ilaro-org/Calypso/README.md

# Calypso
an ffm delta 3d printer forked from the [kossel](https://github.com/jcrocholl/kossel)

check manuals for BOM and instructions on how to calibrate a delta using marlin/repetier firmwares

all sources released under GPL v3
