ilaro-org/Calypso/sources/dxf/alu bed^bed_V2.DXF

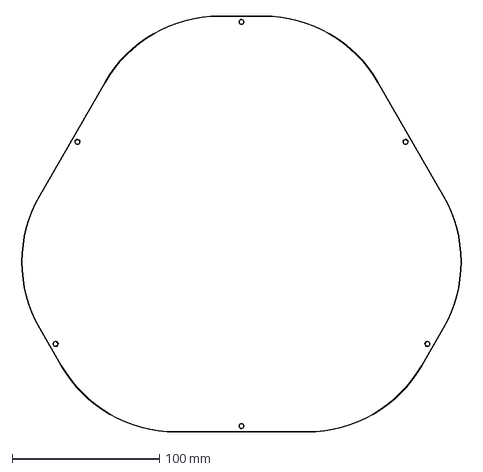
[picture p1: CAD file, 2015-12-09]
sources/dxf/alu bed^bed_V2.DXF
306.7 x 282.8 mm
