ilaro-org/Calypso/sources/stl/endstop holder_V2.STL

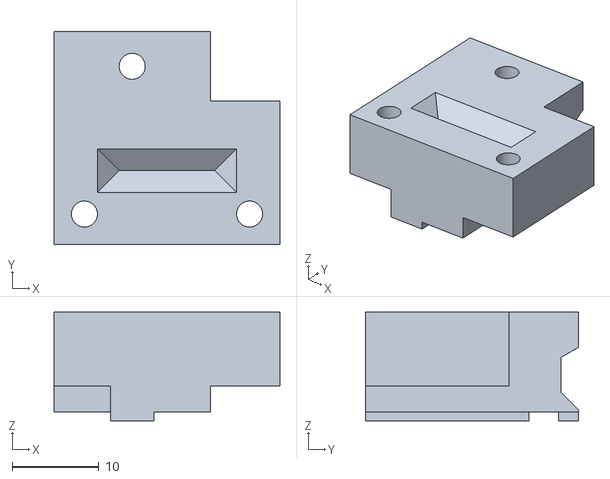
[picture p2: CAD file, 2015-12-09]
sources/stl/endstop holder_V2.STL
26.0 x 24.5 x 12.5
