ilaro-org/Calypso/sources/dxf/subbed_V2.DXF

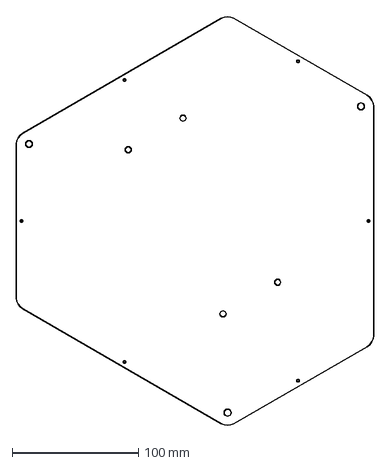
[picture p3: CAD file, 2015-12-09]
sources/dxf/subbed_V2.DXF
282.8 x 324.3 mm
