ilaro-org/Calypso/sources/stl/vertex_V2.STL

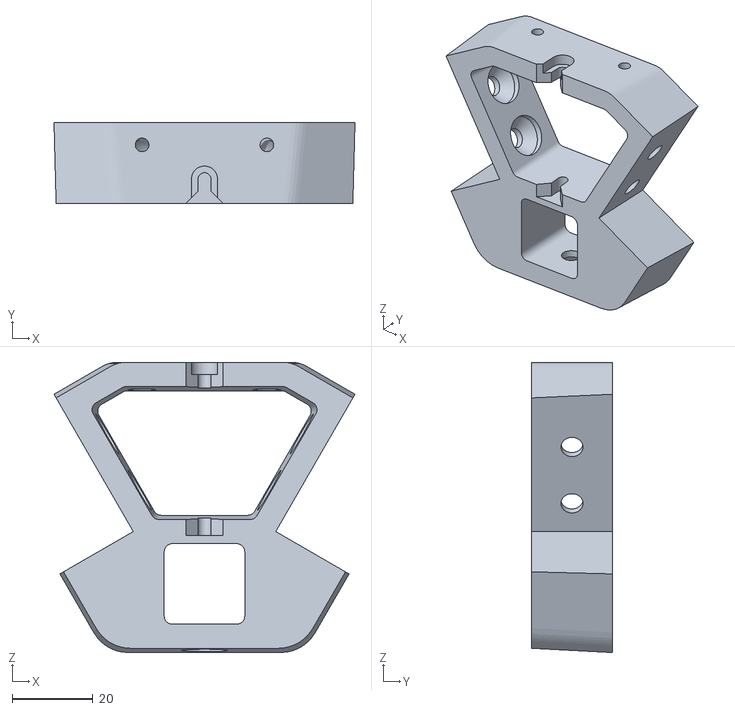
[picture p4: CAD file, 2015-12-09]
sources/stl/vertex_V2.STL
74.8 x 20.0 x 72.0
