ilaro-org/Calypso/sources/dxf/front plate holder_2.DXF

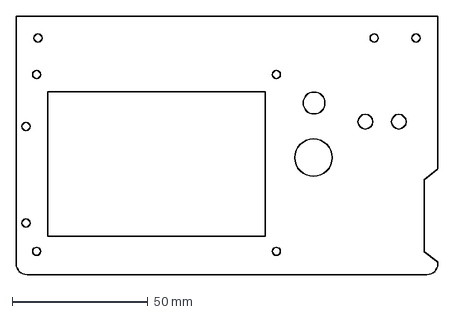
[picture p5: CAD file, 2015-12-09]
sources/dxf/front plate holder_2.DXF
155.0 x 95.0 mm
