ilaro-org/Calypso/sources/stl/hotend holderb_v4.STL

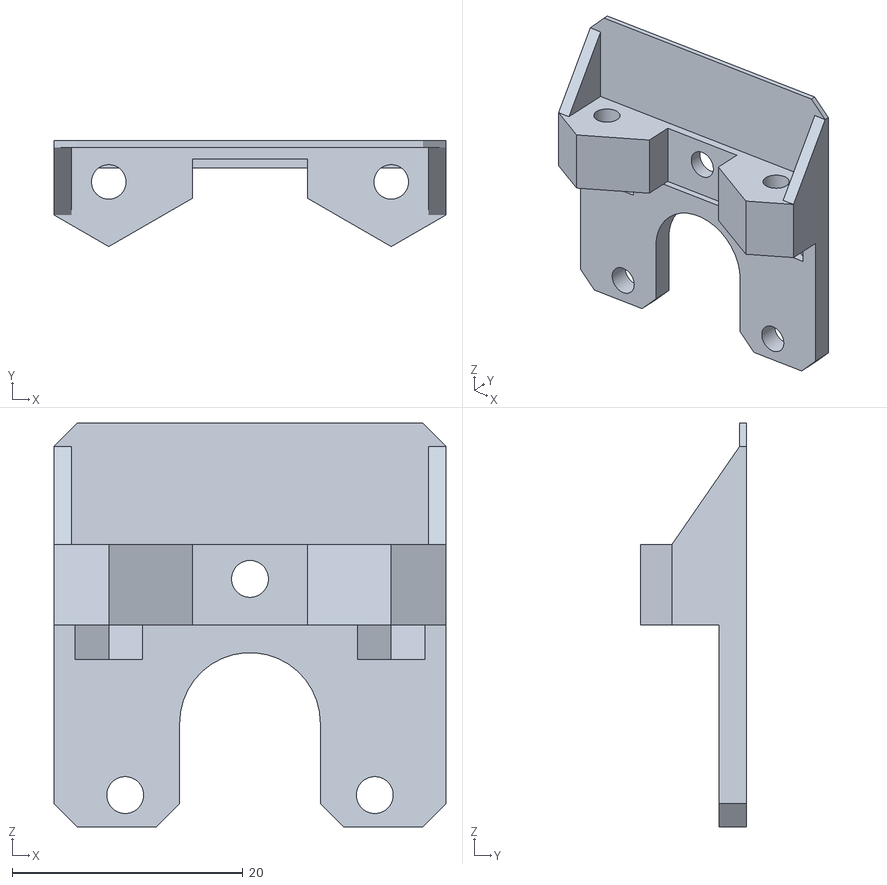
[picture p6: CAD file, 2015-12-09]
sources/stl/hotend holderb_v4.STL
34.0 x 9.21 x 35.0
