ilaro-org/Calypso/sources/dxf/power_plate_V2.DXF

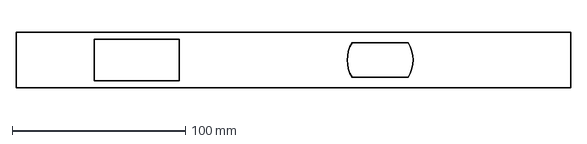
[picture p7: CAD file, 2015-12-09]
sources/dxf/power_plate_V2.DXF
320.0 x 32.2 mm
