ilaro-org/Calypso/sources/stl/extruder holder_V2.STL

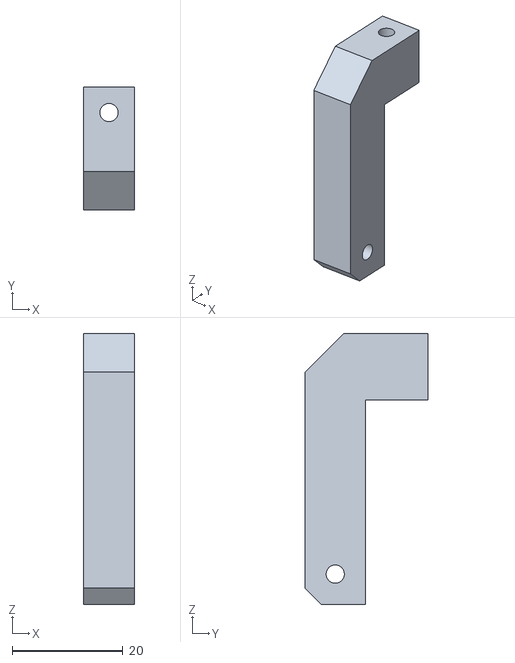
[picture p8: CAD file, 2015-12-09]
sources/stl/extruder holder_V2.STL
9.30 x 22.3 x 49.0
