ilaro-org/Calypso/sources/stl/Push filament_V2.STL

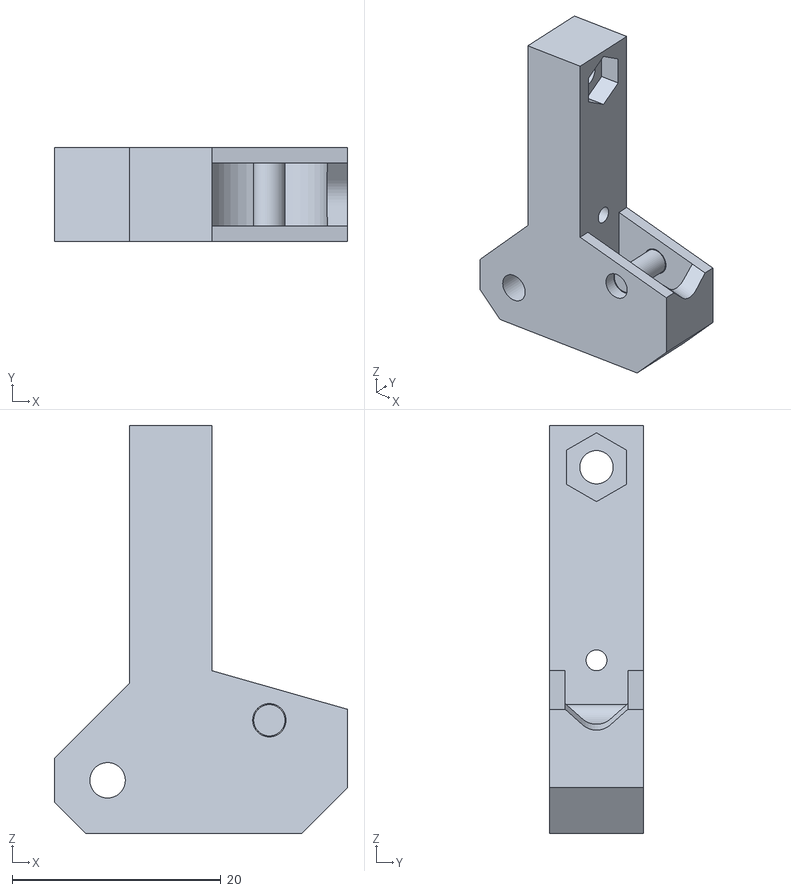
[picture p9: CAD file, 2015-12-09]
sources/stl/Push filament_V2.STL
28.1 x 9.00 x 39.1
