ilaro-org/Calypso/sources/stl/layerfan duct.STL

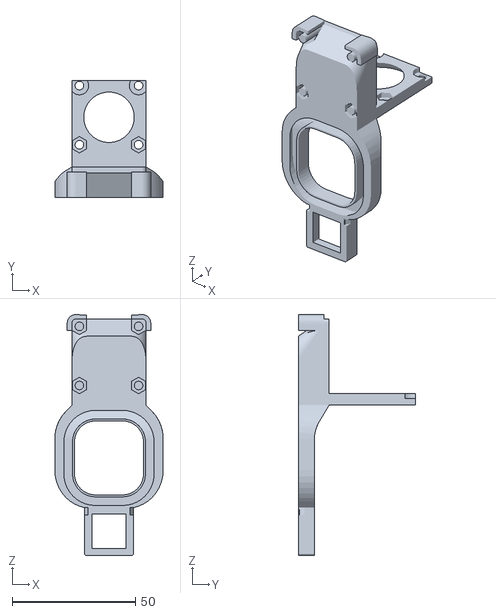
[picture p10: CAD file, 2015-12-09]
sources/stl/layerfan duct.STL
44.0 x 47.6 x 97.8
