ilaro-org/Calypso/sources/stl/Pull filament_V2.STL

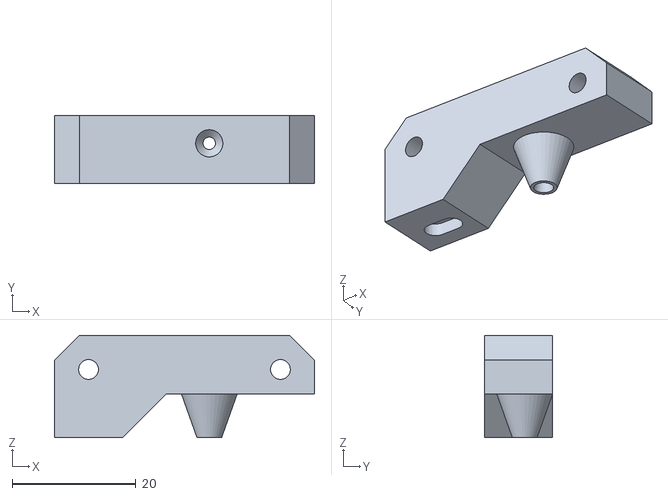
[picture p11: CAD file, 2015-12-09]
sources/stl/Pull filament_V2.STL
42.0 x 11.0 x 16.5
