ilaro-org/Calypso/sources/stl/carriage_V2.STL

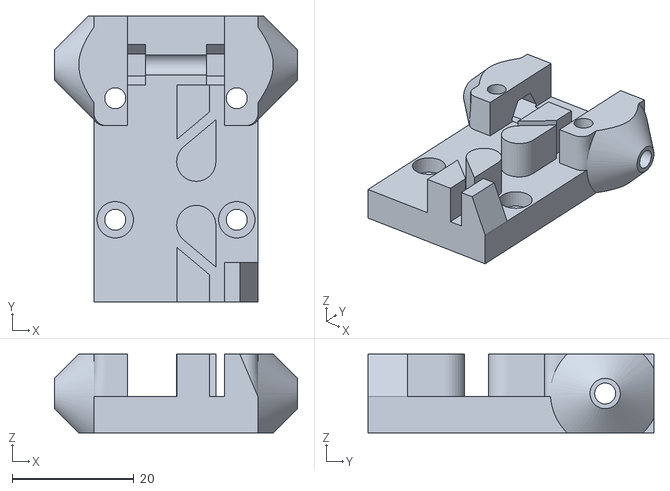
[picture p12: CAD file, 2015-12-09]
sources/stl/carriage_V2.STL
40.0 x 47.0 x 13.0
