ilaro-org/Calypso/sources/stl/spool_V2.STL

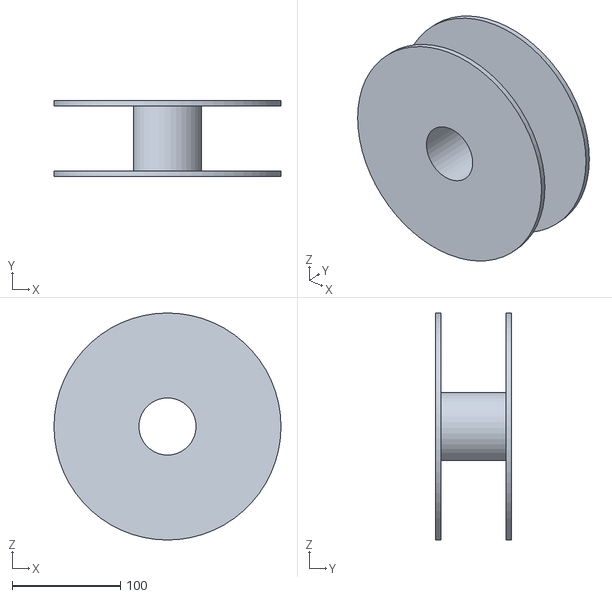
[picture p13: CAD file, 2015-12-09]
sources/stl/spool_V2.STL
210.0 x 70.0 x 210.0
