ilaro-org/Calypso/sources/stl/endeffector_V2.STL

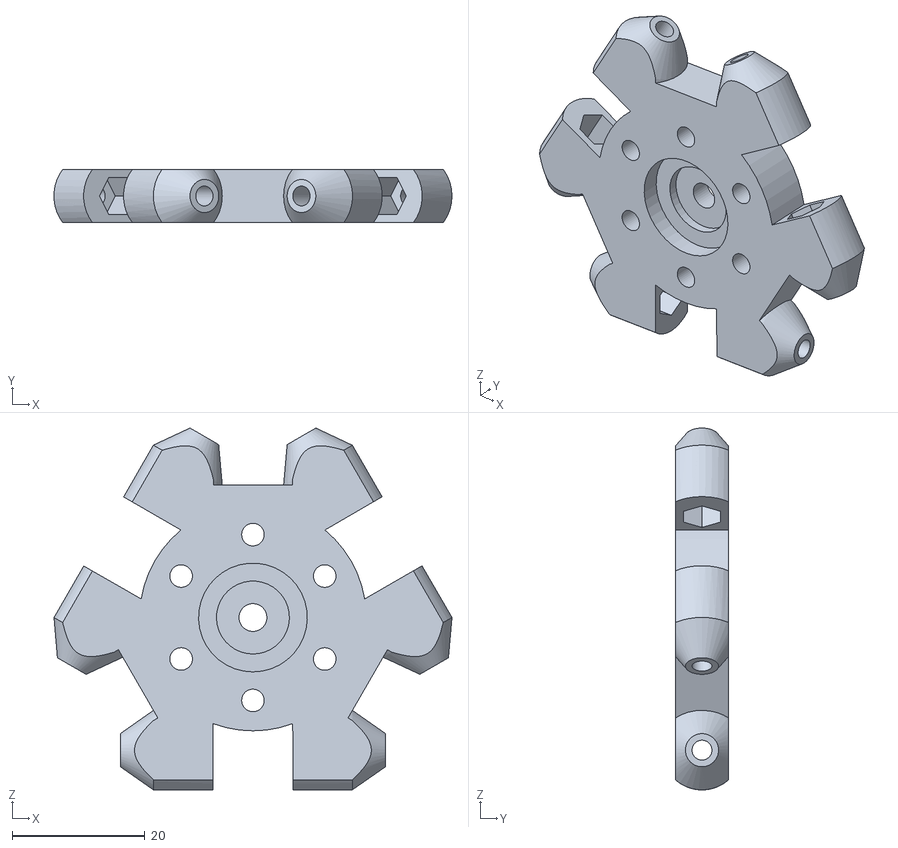
[picture p14: CAD file, 2015-12-09]
sources/stl/endeffector_V2.STL
60.0 x 8.00 x 54.6
