ilaro-org/Calypso/manuals/manual_Clayprinter_ingles.pdf

# CLAY

### VERSION 1

## ILARO.ORG

### 3D PRINTING MANUAL WITH EXTRUSION OF PASTES

CALYPSO DELTA - LICENCIA GPL.V3.

# Modified Printer for extrusion of pastes

# 1.Auger

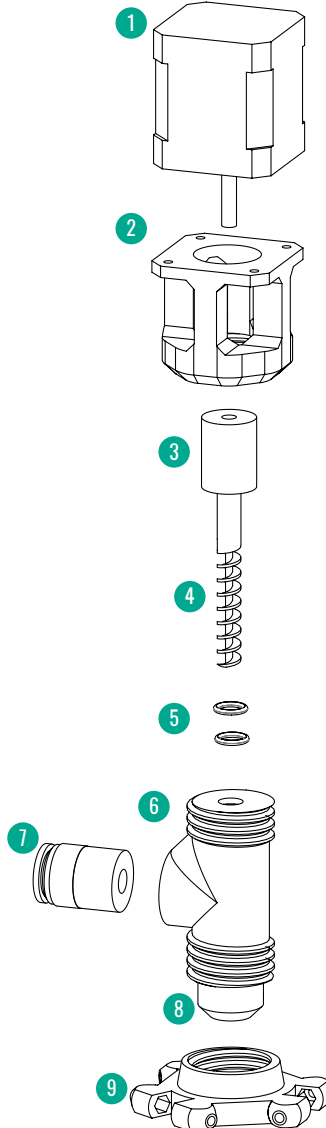
[picture p24: figure]

1 - Motor Nema 17
2 - Motor Coupler
3 - Coupling
4 - Auger Screw
5 - o - Ring
6 - Stator
7 - Racor G1-2
8 - Nozzle
9 - End effector

CALYPSO DELTA printer modified for 3d printing of paste extrusion. The extruder has been modified and has an inlet that is connected to a clay container. This clay is extruded thanks to the force of an air compressor at 4 -6 bar.
A motor connected with a coupler to a worm screw has been incorporated that allows to control the passage of the clay and to make retractions.
The noozle is 2.5 mm and 5 mm in diameter. The maximum printing volume is 280 diameter x 340 mm.

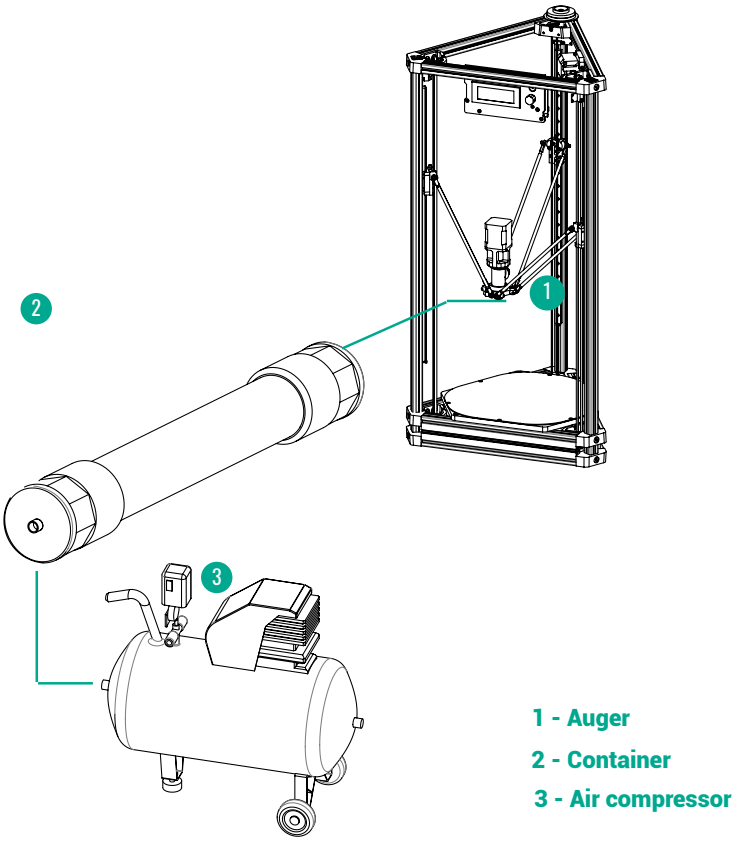
[picture p25: figure]
1 - Auger 2 - Container 3 - Air compressor

# 2.clay container

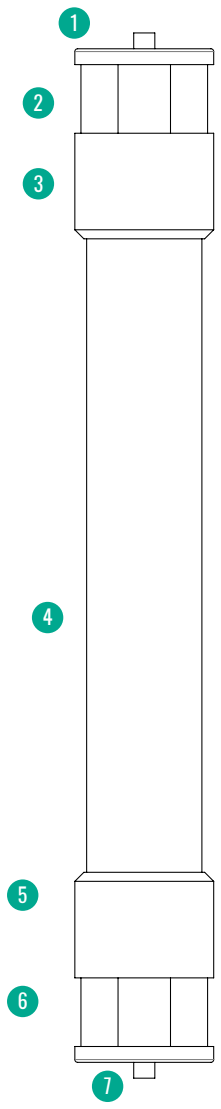
[picture p26: figure]

1 - Racor G1-2

7 - Racor G1-2

2 - Plug 2” inches

6 - Plug 2” inches

3 - Thread 2 “inches

5 - Thread 2 “inches

4 - PVC tube pressure 63 mm diameter

STEP 1 STEP 2
Export the file from Grasshopper | Export as .gcode

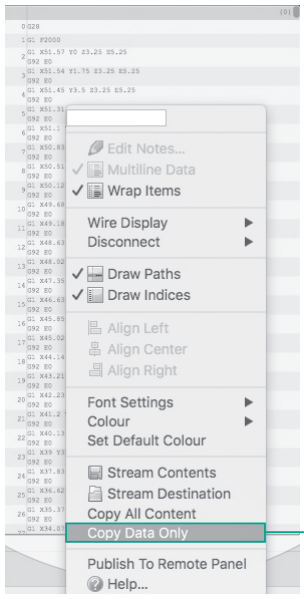
[picture p27: figure]
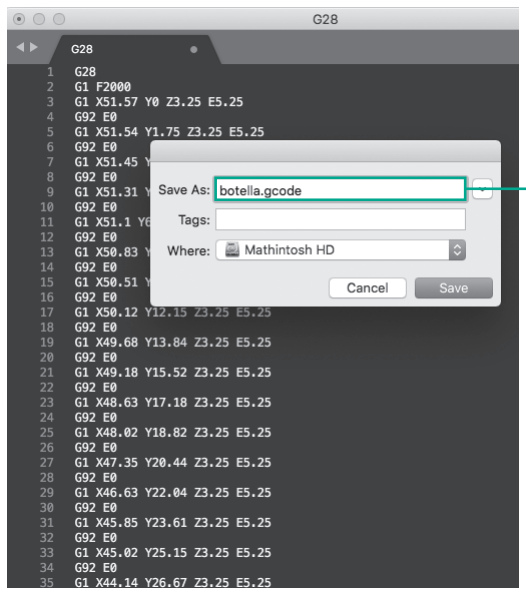
[picture p28: figure]

To print in 3d we need to export the code that we will find in the Grasshopper file.
Select the last panel and right click.
Select “Copy Data Only”.

Next we will open a text or source code editor such as “Sublime text”.
or by default the one that we will have in the computer as “notes”.

Copy the code and save it on an SD card as: name.gcode

STEP 3 STEP 4
preparation | container

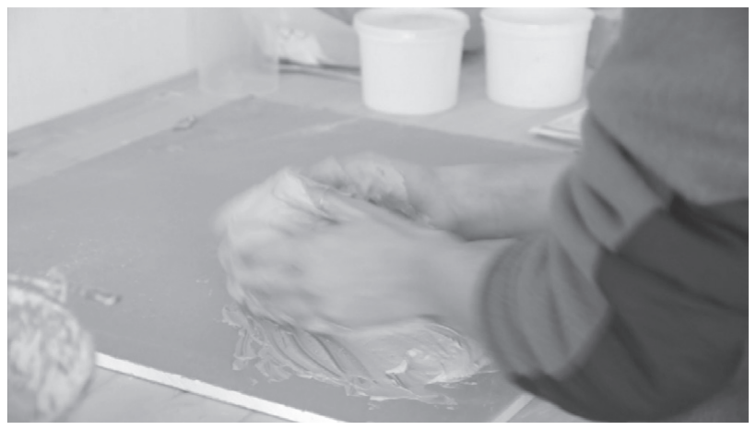
[picture p29: figure]

For the load of paste we will be able to use:

- High temperature stoneware without deflocculant
- High-temperature B2 porcelain without deflocculant.

It is important that the paste is not deflocculated since normally the ceramic powders come prepared to make molds, the deflocculant allows that with less amount of water the clay has fluidity and plasticity. For 3d printing we are interested in the clay maintaining its original structure and not being processed.

We will calculate a proportion that has the consistency that we look for to extrude with the printer.

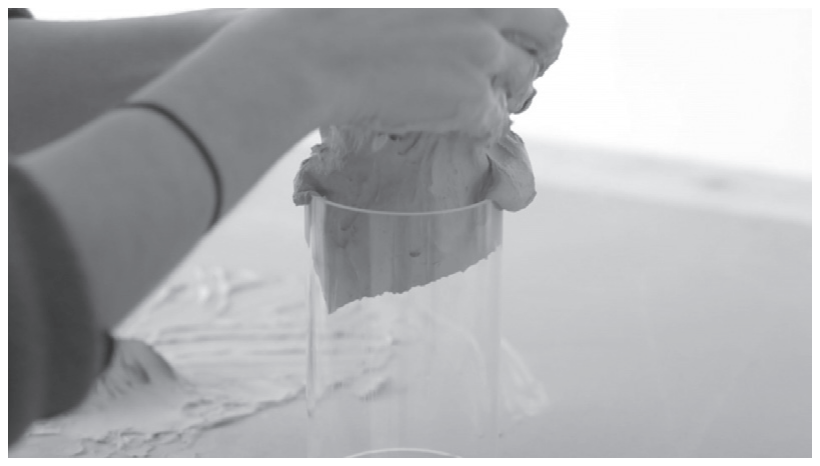
[picture p30: figure]

### 1 part water x 3 part clay

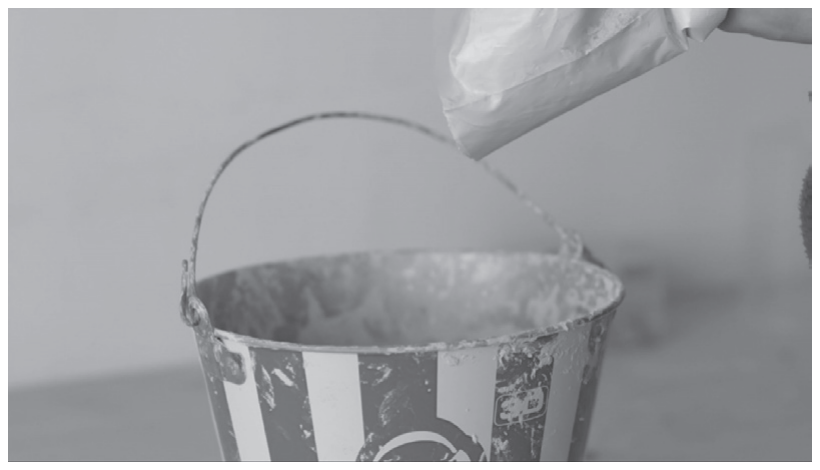
[picture p31: figure]

for this container we need 1900 grams of Stoneware.

Knead with your hands on a flat surface until a homogeneous dough is obtained.

without letting air bubbles into the container.

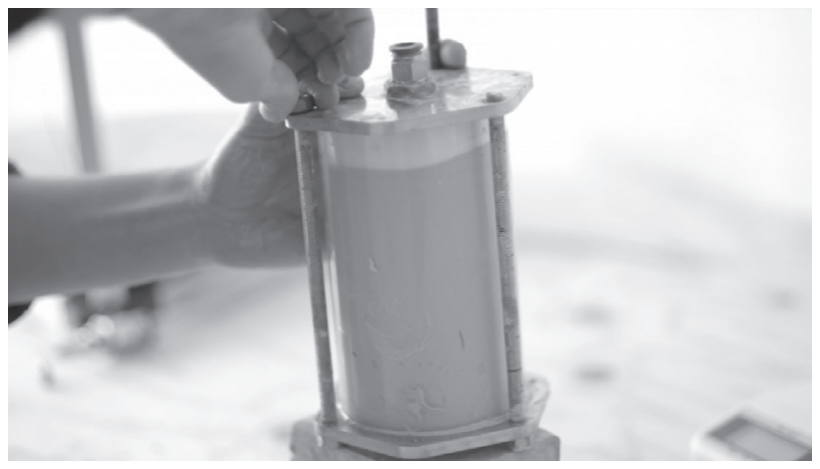
[picture p32: figure]

close the container making sure that it is tight and there are no air leaks.

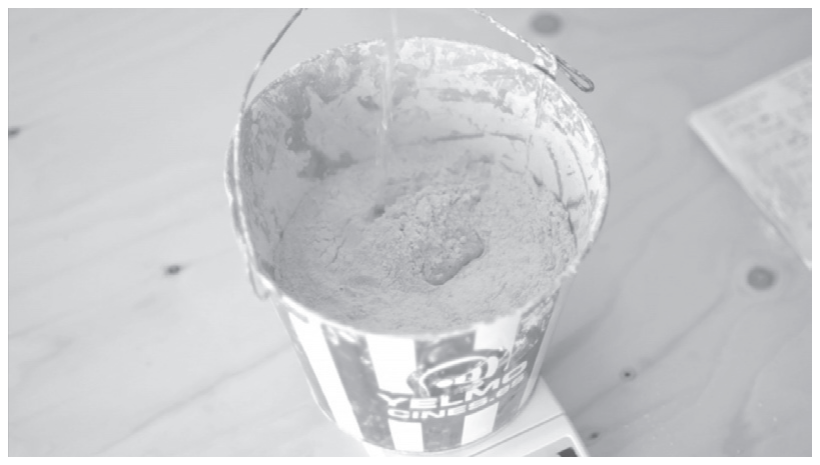
[picture p33: figure]

we need 633,33 ml of water

STEP 5 STEP 6
Connect to air compressor | Printing the file

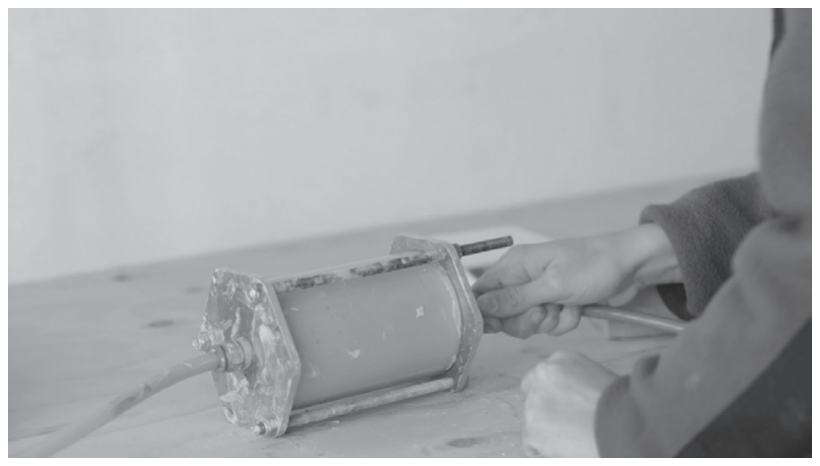
[picture p34: figure]

Connect the container to the air compressor by adjusting the tube well, making sure that no air is lost.

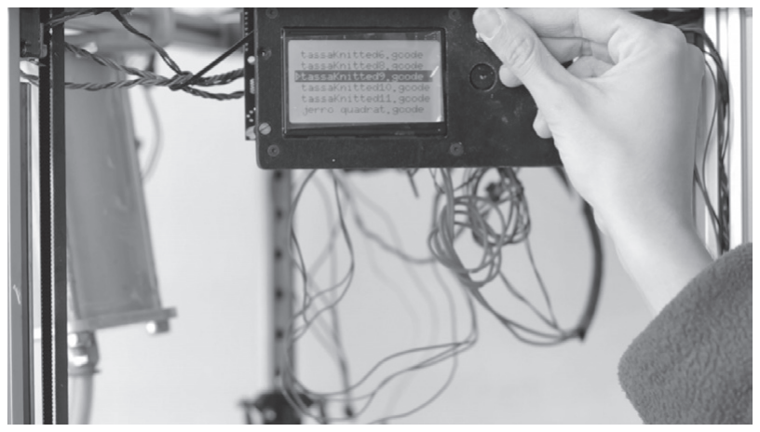
[picture p35: figure]

Connect SD to the printer slot on the left side of the screen. Automatically the menu of the sd card will appear and with the metallic button we will look for our file.
Otherwise we will search in the printer menu “Print file”.

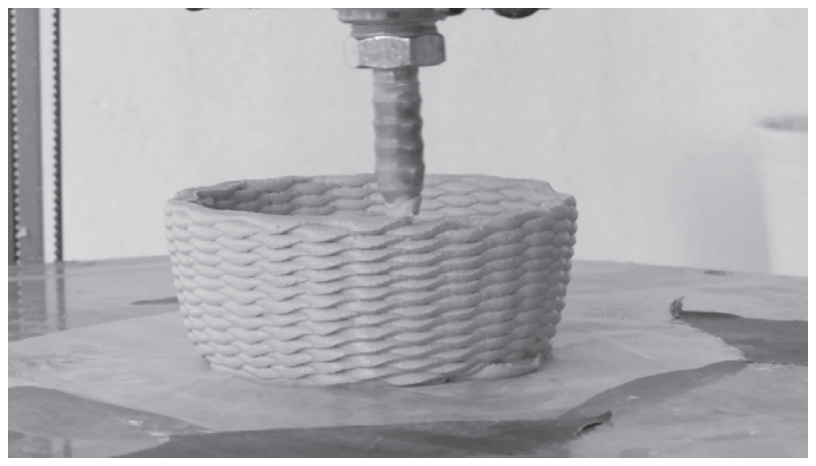
[picture p36: figure]
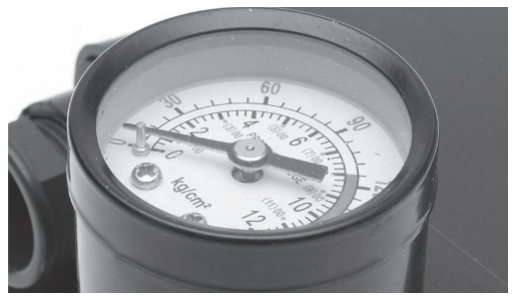
[picture p37: figure]

Adjust the air force of the compressor.
Normally we use a paste of this density between 4 to 6 bars. We must fix this force well so that a homogeneous piece comes out.

Our file will then be printed.
We must continuously ensure that the force of the air is constant and that the container does not lose air.

If the part does not extrude well it is possible that :
- clay has dried in the nozzle.
- Do not have enough force to extrude the paste and we must raise the bars of the compressor.
- The code is not correct.
- Lose air

2019 | ilaro.org

LICENCIA GPL.V3.

MANUAL by
Valeria Ustárez
