ilaro-org/Calypso/manuals/manual_Cnc_ingles.pdf

# CNC

### VERSION 1

## ILARO.ORG

### MANUFACTURING MANUAL SUSTRACTIVE

CALYPSO DELTA - LICENCIA GPL.V3.

Subtractive (CNC, turning, drilling) | Agama cnc

1 -Frame Y
2 - Frame X

Subtractive manufacturing begins with a block of solid material, and uses cutting tools
to extract the material and achieve a final shape. Milling, turning, drilling and cutting operations are examples of subtractive techniques. Subtractive manufacturing is capable of producing high precision parts with excellent surface finish.

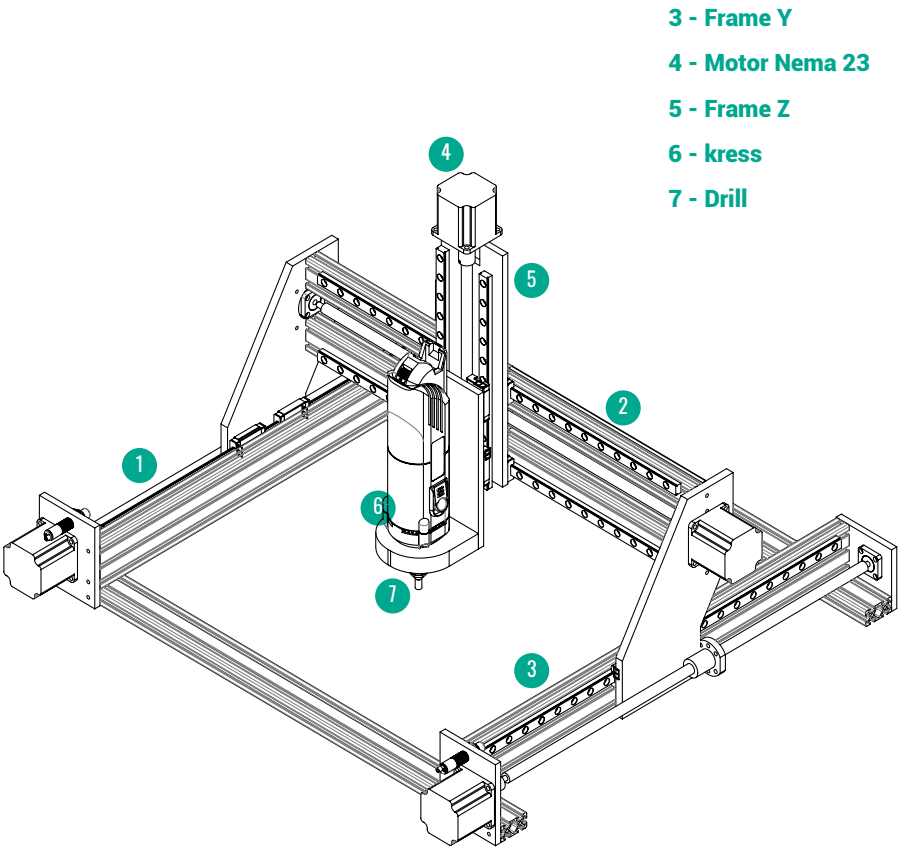
[picture p38: figure]
3 - Frame Y 4 - Motor Nema 23 5 - Frame Z 6 - kress 7 - Drill

Subtractive manufacturing is limited by a number of factors. Most designs require computer-aided manufacturing (CAM) to trace tool paths and efficient material removal. Tool access must also be taken into account when designing parts for subtractive manufacturing, as the cutting tool must be able to reach all surfaces to remove material.

Subtractive manufacturing is also generally considered a wasteful process, due to the large amounts of material that are often removed to produce the final part geometry.

STEP 1 STEP 2
Export the file from Grasshopper | Export as .ngc

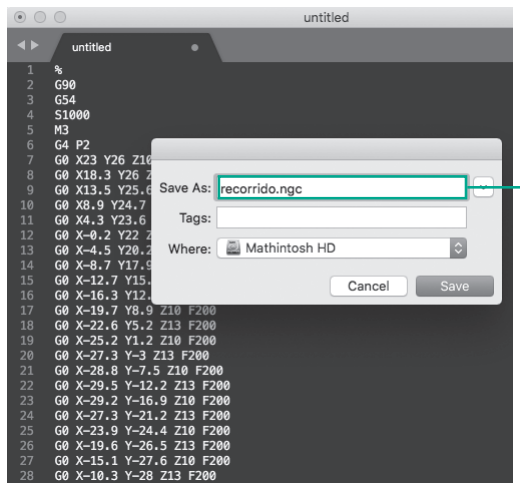
[picture p39: figure]
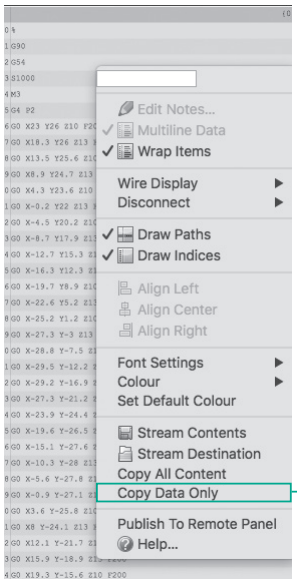
[picture p40: figure]

we need to export the code we’ll find in the Grasshopper file.
Select the last panel and right click.
And then select “Copy Data Only”.

We open a text or source code editor such as “Sublime text”. or by default the one that we will have in the computer as “notes”.

We will copy the code and save it in a Pen drive as: name.ngc

STEP 3 STEP 4
Save in TEC2 folder on the desktop | open Machinekit

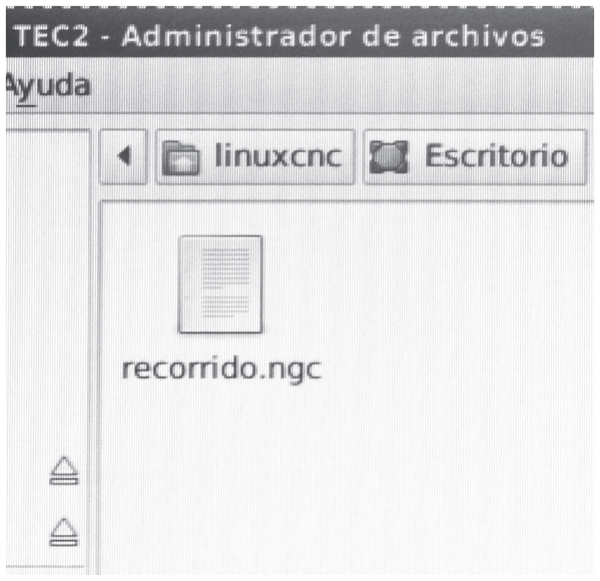
[picture p41: figure]

We’ll save our file in the desktop folder called TEC2.

We open in the Machinekit desktop.( with the name of the cnc that we are using) It is a platform for machine control applications.

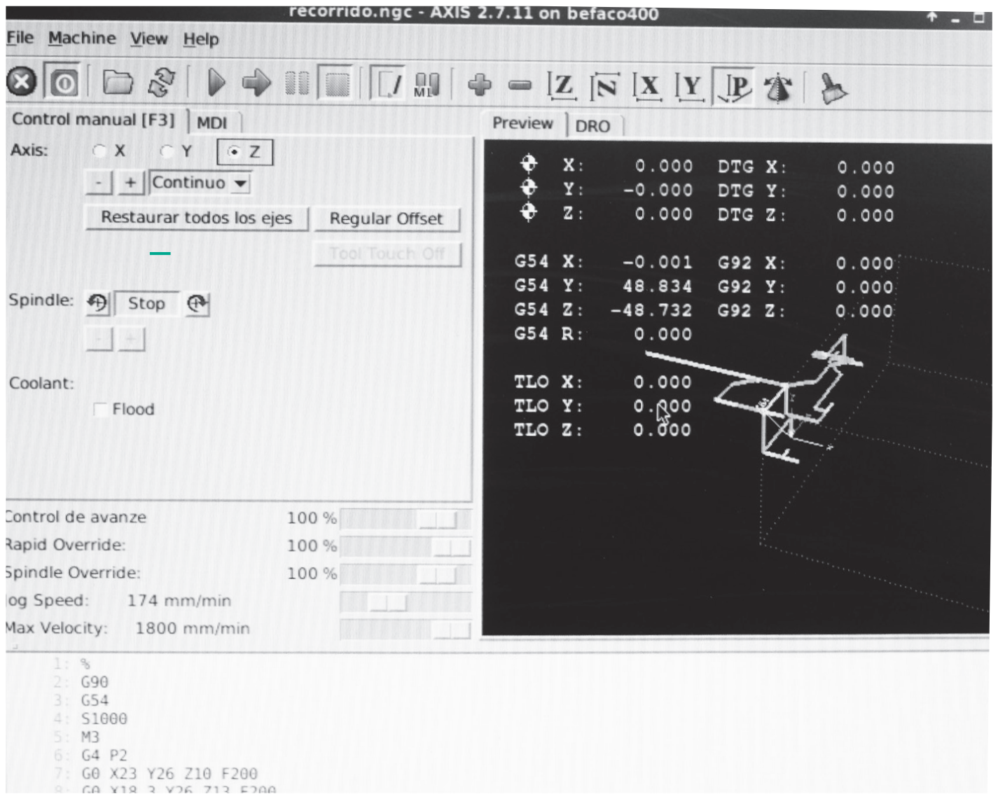
[picture p42: figure]

STEP 5

# Fix material

STEP 6

# Change drill bit

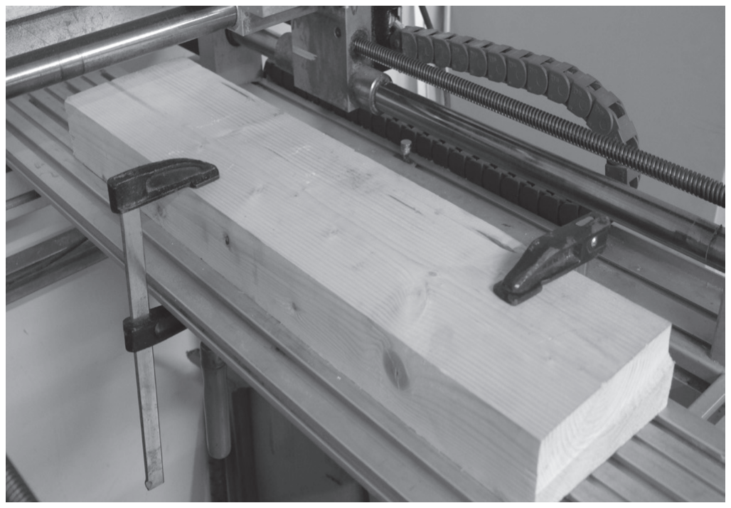
[picture p43: figure]
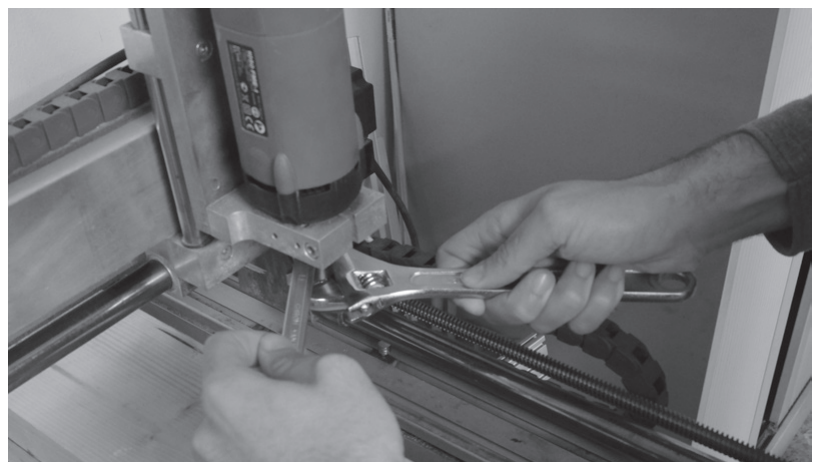
[picture p44: figure]

We can change the drill bit with two wrenches pressing in.

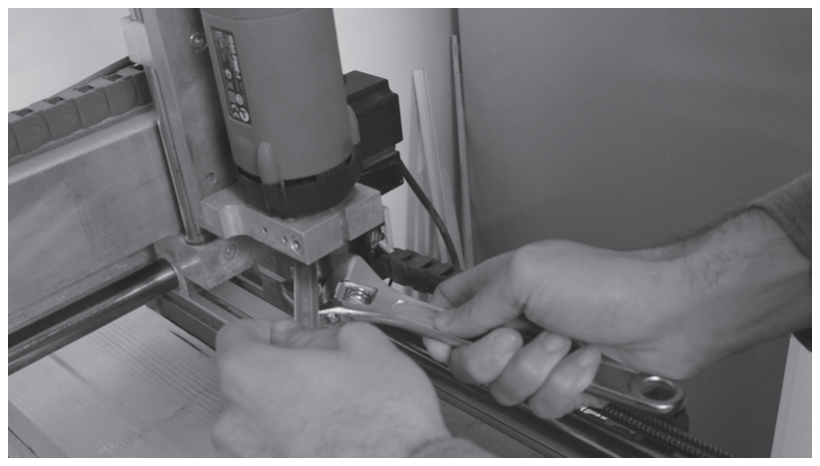
[picture p45: figure]

To adjust drill press out.

STEP 7 STEP 8
Open .ngc file from Machinekit | Turn on/restore all axes

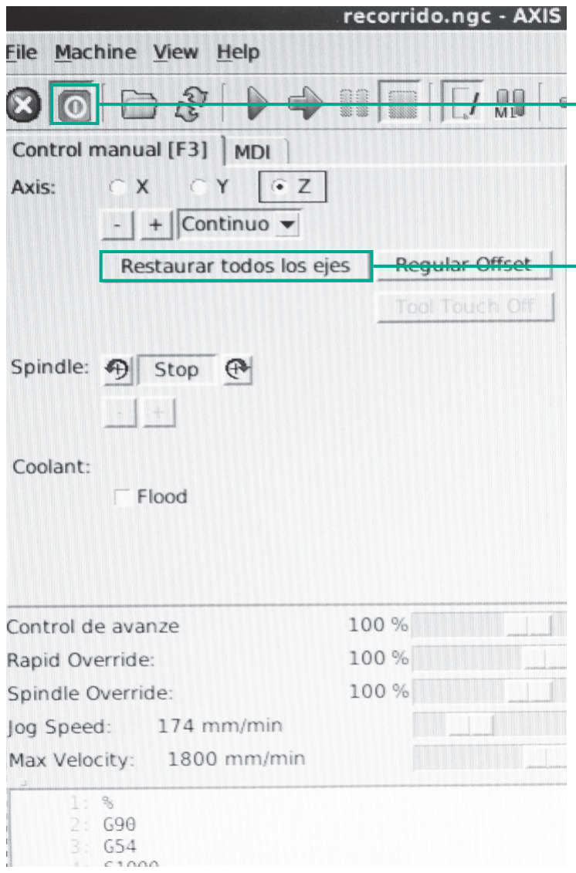
[picture p46: figure]
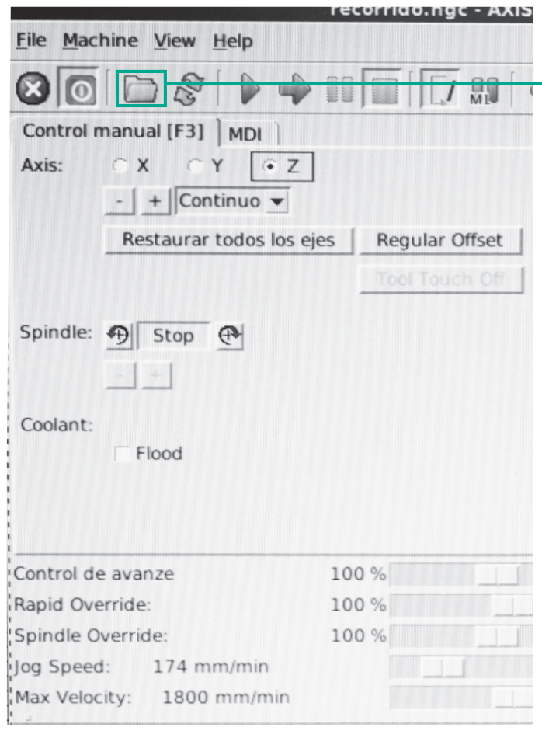
[picture p47: figure]

Turn on the cnc from Machinekit and restore all the axes (home)

We look for the icon of the folder to open the file in TEC2

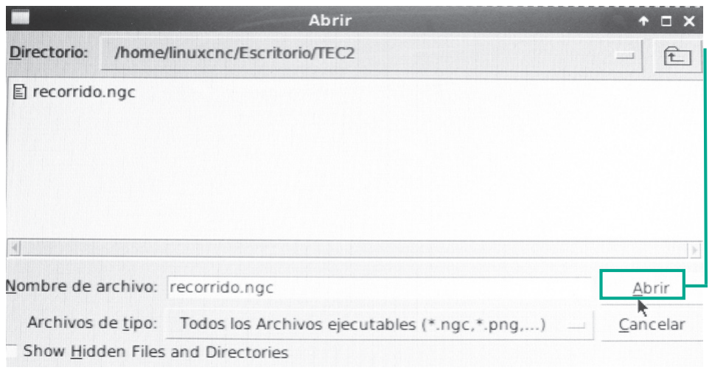
[picture p48: figure]

We look for the TEC2 folder on the desktop and proceed to open.

STEP 9 STEP 10

# Commands to move with the machine

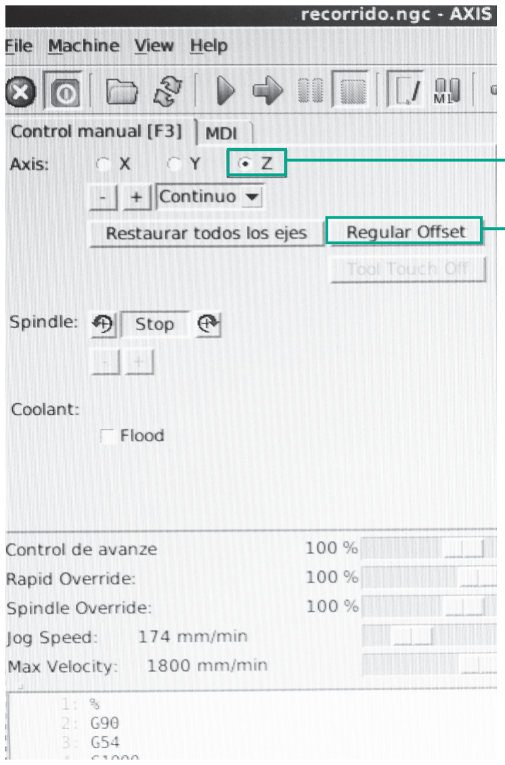
[picture p49: figure]

Move on the XY axes
right left

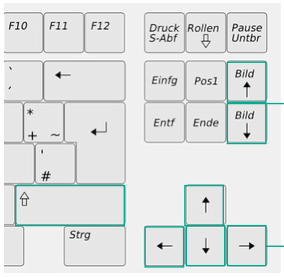
[picture p50: figure]

Move in the Z axes

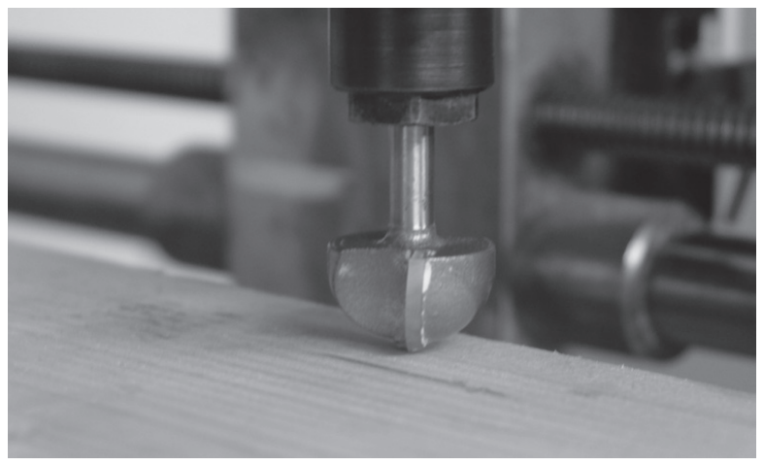
[picture p51: figure]

To move in the space we will use the following commands in the keyboard:

Pressing:

SHIFT (to go faster)+ (XYZ axis keys)

Select our start of coordinate axis by placing the drill in position “X0 Y0 Z0”.

# X Y Z axis configuration

To define our position
X0 Y0 Z0.

Let’s select for example:
the Axis Z and then select Regular offset. Repeat the operation with the axis Y , X

STEP 11 STEP 12

# start

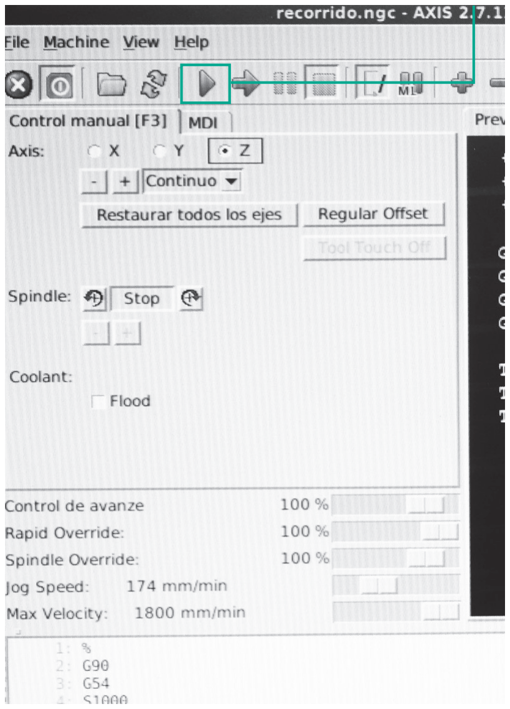
[picture p52: figure]
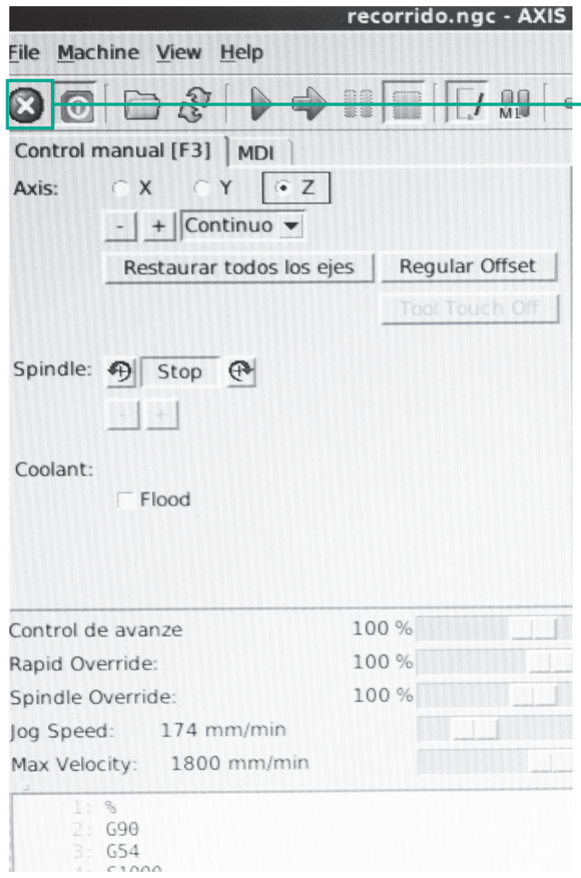
[picture p53: figure]

To cancel printing press this button

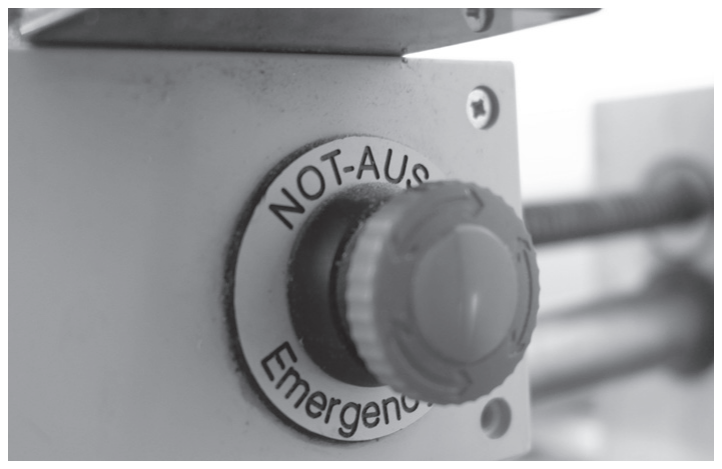
[picture p54: figure]
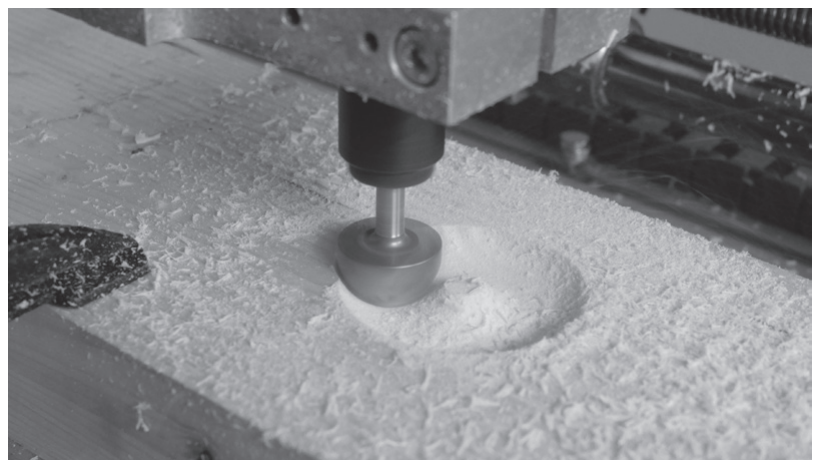
[picture p55: figure]

EMERGENCY OFF

# Emergency Power Off

play to start

2019 | ilaro.org

LICENCIA GPL.V3.

MANUAL BY
Valeria Ustárez
