ilaro-org/Calypso/manuals/manual cnc.pdf

# CNC

### VERSION 1

## ILARO.ORG

### MANUAL DE FABRICACIÓN SUSTRACTIVA

CALYPSO DELTA - LICENCIA GPL.V3.

Sustractivo (CNC, torneado, taladrado) | Agama cnc

1 -Frame Y
2 - Frame X

La fabricación sustractiva comienza con un bloque de material sólido, y utiliza
herramientas de corte para extraer el material y lograr una forma final. Las operaciones de fresado, torneado, taladrado y de corte, son ejemplos de técnicas sustractivas. La fabricación sustractiva es capaz de producir piezas de alta precisión con un excelente acabado superficial.

3 - Frame Y 4 - Motor Nema 23 5 - Frame Z 6 - kress 7 - Drill

La fabricación sustractiva está limitada por una serie de factores. La mayoría de los diseños requieren fabricación asistida por ordenador (CAM) para trazar las trayectorias de las herramientas y la eliminación eficiente del material.
El acceso a la herramienta también debe tenerse en cuenta al diseñar piezas para la fabricación sustractiva, ya que la herramienta de corte debe ser capaz de llegar a todas las superficies para eliminar material.

La fabricación sustractiva también se considera generalmente un proceso derrochador, debido a las grandes cantidades de material que a menudo se eliminan para producir la geometría final de la pieza.

STEP 1 STEP 2
Exportar el archivo desde Grasshopper | Exportar como .ngc


necesitamos exportar el código que encontraremos en el archivo de Grasshopper. Seleccionaremos el último panel y damos click derecho.
Y a continuación seleccionamos “ Copy Data Only”

Abrimos un editor de texto o de código fuente como por ejemplo “Sublime text“.
o por defecto el que tendremos en el ordenador como “notes”.

Copiaremos el código y lo
guardaremos en un Pen drive como: nombre.ngc

STEP 3 STEP 4
guardar en carpeta TEC2 en el escritorio | abrir Machinekit


Guardaremos nuestro archivo en la carpeta del escritorio llamada TEC2.

Abrimos en el escritorio Machinekit.( con el nombre de la cnc que estamos utilizando) Es una plataforma para aplicaciones de control de máquinas.


STEP 5

# Fijar material

STEP 6

# Cambiar broca


Podemos cambiar la broca con dos llaves inglesas presionando hacia dentro.


Para ajusta broca presionar hacia fuera.

STEP 7 STEP 8
Abrir archivo .ngc desde Machinekit | Encender/Restaurar todos los ejes


Encendemos la cnc desde Machinekit y restauramos todos los ejes (home)

Buscamos el icono de la carpeta para abrir el archivo de la carpeta
TEC2


Buscamos la carpeta TEC2 en el escritorio y procedemos a abrir.

STEP 9 STEP 10

# Comandos para movernos con la máquina


Movernos en los ejes XY
derecha izquierda


Movernos en los ejes Z
derecha izquierda


Para movernos en el espacio utilizaremos los siguientes comandos en el teclado:

Presionando:

SHIFT (para ir más rápido)+ (teclas ejes XYZ)

Seleccionamos nuestro inicio de eje de coordenadas colocando la broca en la posición “ X0 Y0 Z0 ”.

# Configuración de ejes X Y Z

Para definir nuestra posición
X0 Y0 Z0.

Seleccionaremos por ejemplo:
el Axis Z y luego seleccionaremos Regular offset. Repetiremos operación con el axis Y , X

STEP 11 STEP 12

# Inicio


Para cancelar la impresión apretar a este botón


Apagado de EMERGENCIA

# Apagado de emergencia

darle al Play

2019 | ilaro.org

LICENCIA GPL.V3.

MANUAL REALIZADO POR
Valeria Ustárez
