ilaro-org/Calypso/manuals/manual 3Dprinter.pdf

# PLA

### VERSION 1

## ILARO.ORG

### MANUAL DE IMPRESIÓN 3D CON FILAMENTOS

CALYPSO DELTA - LICENCIA GPL.V3.

Additive (3D printing) | Calypso Delta


1 - Pla Filament
2 - SD Card
3 - Shield LCD
4 - Pull filament
5 - Push fit
6 - Heatsink
7 - Fan
8 - Noozle
9 - Hot bed
10 - Power On/Off

La fabricación aditiva (más comúnmente conocida como impresión en 3D) es el proceso de construcción aditiva de una pieza, capa a capa. Existe una amplia gama de tecnologías de impresión en 3D, cada una con sus propios beneficios y limitaciones, y cada una es capaz de imprimir piezas de diferentes materiales.

Se puede producir casi cualquier geometría, es uno de los puntos fuertes de la impresión en 3D (aunque todavía hay reglas que debemos tener en cuenta segun la tecnología). Además, la impresión en 3D no se basa en costosas herramientas, lo que tiene como ventaja la rápida verificación y desarrollo de prototipos y piezas de producción de bajo volumen.
Una de las mayores limitaciones de la impresión en 3D es la incapacidad de producir piezas con propiedades de material equivalentes a las realizadas mediante técnicas sustractivas o formativas.

La impresión en 3D también tiene limitaciones en cuanto a la repetibilidad, lo que significa que las piezas a menudo presentan ligeras variaciones debido al enfriamiento diferencial o a la deformación durante el curado.

STEP 1 STEP 2
Exportar el archivo .STL | Configuración del laminado


Para imprimir con la impresora 3d necesitamos un modelo STL . El archivo lo podemos conseguir previamente modelando el objeto con cualquier software de modelado 3D (Sketchup, Rhinoceros, SolidWorks, etc..)


Seleccionamos “guardar como” y guardamos con la extensión .stl (Stereolithography)

Layer height (mm)
altura de capa entre 0.1 a 0.4.
a menor altura más calidad.

Shell thickness (mm)
Este parámetro determina la anchura del borde del objeto (diámetro de la boquilla del hotend x num. de vueltas que queramos dar al objeto)

Fill Density (%)
este valor indica el relleno que va a tener la figura. 20% para piezas artísticas , 80% para piezas que deban soportar peso o esfuerzos.

Enable retraction
Esta opción permite que en los desplazamientos el extrusor retraiga un poco el plástico para que no gotee

Printing temperature (C)
temperatura del hotEnd a la que vamos a imprimir. Para el PLA entre 190º-210º Support type
crea soportes donde sea necesario en partes de la pieza que estan al aire y no se pueden suspender.

Filamet diameter (mm)
Establece el diámetro del filamento que estemos usando. En nuestro caso siempre será 1.75 mm

Para imprimir nuestro archivo .STL utilizaremos CURA, que es un programa “Open Source” desarrollado por ultimaker para el laminado de objetos 3D. Desde este programa se pueden realizar todos los pasos necesarios para pasar de un modelo 3D a un objeto real. A continuación explicaremos los parámetros mas importantes a tener en cuenta para imprimir nuestra pieza.

STEP 3 STEP 4

# Imprimir


Insertar tarjeta SD en la ranura de la pantalla por la parte izquierda


Seleccionar apretando el botón metálico.

Imprimiendo


Buscar nuestro archivo .gcode en el menu de la tarjeta girando el botón metálico

Después exportaremos como
nombre.gcode y lo guardaremos en una tarjeta SD

# Exportar el archivo .gcode

2019 | ilaro.org

LICENCIA GPL.V3.

MANUAL REALIZADO POR
Valeria Ustárez
