ilaro-org/Calypso/manuals/manual Clayprinter.pdf

# CLAY

### VERSION 1

## ILARO.ORG

### MANUAL DE IMPRESIÓN 3D CON EXTRUSIÓN DE PASTAS

CALYPSO DELTA - LICENCIA GPL.V3.

# Impresora modificada para extrusión de pastas

# 1.Auger


1 - Motor Nema 17
2 - Motor Coupler
3 - Coupling
4 - Auger Screw
5 - o - Ring
6 - Stator
7 - Racor G1-2
8 - Nozzle
9 - End effector

Impresora CALYPSO DELTA modificada para la impresión 3d de extrusión de pastas. Se ha modificado el extrusor y tiene una entrada que esta conectada a un contenedor de barro. Este barro se extruye gracias a la fuerza de un compresor de aire a 4 -6 bar.
Se ha incorporado un motor conectado con un coupler a un tornillo sin fin que permite controlar el paso del barro y hacer retracciones.
El noozle es de 2,5 mm y 5 mm de diámetro . El máximo volumen de impresión es de 280 diámetro x 340 mm.

1 - Auger 2 - Container 3 - Air compressor

# 2.Contenedor de pasta


1 - Racor G1-2

7 - Racor G1-2

2 - Tapón 2“ pulgadas

6 - Tapón 2“ pulgadas

3 - Rosca 2“pulgadas

5 - Rosca 2“pulgadas

4 - Tubo PVC presión 63 mm de diámetro

STEP 1 STEP 2
Exportar el archivo desde Grasshopper | Exportar como .gcode


Para imprimir en 3d necesitamos exportar el código que encontraremos en el archivo de Grasshopper.
Seleccionaremos el último panel y damos click derecho.
Seleccionamos “ Copy Data Only”

A continuación abriremos un editor de texto o de código fuente como por ejemplo “Sublime text“. o por defecto el que tendremos en el ordenador como “notes”.

Copiaremos el código y lo
guardaremos en una tarjeta SD como: nombre.gcode

STEP 3 STEP 4
Preparación de pasta | carga de contenedor


Para la carga de pasta podremos utilizar:

- Gres de alta temperatura sin defloculante
- Porcelana B2 de alta temperatura sin defloculante.

Es importante que la pasta no este defloculada ya que normalmente los polvos cerámicos vienen preparados para hacer moldes, el defloculante permite que con menos cantidad de agua la arcilla tenga fluidez y plasticidad. Para la impresión 3d nos interesa que la arcilla mantenga su estructura original y que no este procesada.

Calcularemos una proporción que tiene la consistencia que buscamos para extruir con la impresora.


## 1 parte de agua x 3 de barro


Verter en el caso de nuestro contenedor 1900 gramos de Gres.

Amasar con las manos en una superficie plana hasta conseguir masa homogénea

Verter como si fuera una masilla sin dejar entrar burbujas de aire en el contenedor.


cerrar contenedor asegurandonos que esta bien ajustado y no hay perdidas de aire.


Verter en el caso de nuestro contenedor 633,33 ml de agua

STEP 5 STEP 6
Conectar al compresor de aire | Impresión del archivo


Conectar contenedor al compresor de aire ajustando bien la manguera asegurandonos que no pierde aire.


Conectar SD a la ranura de la impresora que se encuentra en la pantalla por la parte izquierda. Automáticamente saldrá el menu de la tarjeta sd y con el botón metálico buscaremos nuestro archivo.
Si no sale el menu directamente de la tarjeta sd buscaremos en el menu de la impresora “Print file”.


Ajustar la fuerza del aire del compresor.
Normalmente utilizamos para una pasta de esta densidad entre 4 a 6 bares. Debemos fijar esta fuerza bien para que nos salga una pieza homogénea.

A continuación se imprimirá nuestro archivo.
Deberemos vigilar continuamente que la fuerza del aire sea constante y que el contenedor no pierda aire.

Si la pieza no extruye bien es posible que :
- Se haya secado barro en la boquilla.
- No tenga suficiente fuerza para extruir la pasta y deberemos subir los bares del compresor.
- El código no este bien.
- Pierda aire

2019 | ilaro.org

LICENCIA GPL.V3.

MANUAL REALIZADO POR
Valeria Ustárez
