ilaro-org/Calypso/manuals/Manual slic3r.pdf

# SLIC3R

### VERSION 1

## ILARO.ORG

### MANUAL DE IMPRESIÓN

CALYPSO DELTA - LICENCIA GPL.V3.

STEP 1 STEP 2
Introducción a Slic3r | Generar modelo STL

Slic3r es un sotware de código abierto diseñado para impresoras 3d bajo licencia GPL, este programa se encuentra en constante revisión, incluye progresivamente nuevas carácteristicas y correciones de errores.

Slic3r genera G-code a partir de modelos digitales 3d (STL y OBJ). Corta modelos en capas horizontales conformando trayectorias, para rellenarlas según los parámetros que especifiquemos, también calcula la cantidad de material a extruir.

El programa es compatible con Microsoft Windows, Mac OS X, Linux.

El programa se puede descargar directamente de http//slic3r.org/download.

Slic3r te permite generar archivos en formatos diferentes para tegnologias varias, en el caso de imprimir con Calypso nuestra impresora de extrusión Delta, deberemos seguir las siguientes instrucciones. Ilaro ha generado una configuración standar que se puede importar al programa fácilmente ‘calypso.ini’.

Para imprimir en 3d necesitamos un modelo STL. El modelo lo podemos consiguir a partir de diferentes métodos:

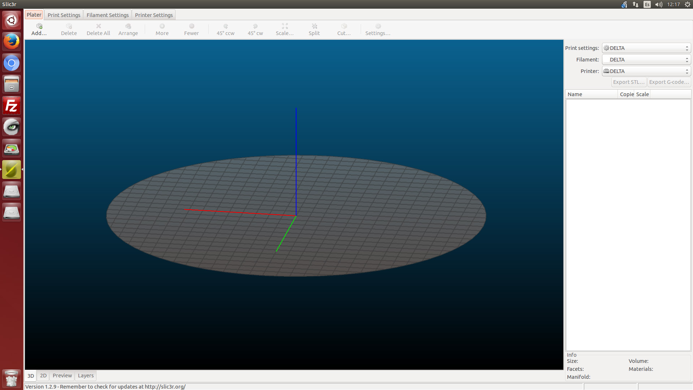
[picture p56: figure]

Algunas veces cuando generamos o encontramos algún modelo 3d, podemos tener erroros de construción, convertir el modelo en no imprimible o generar diversos errores.

Existen programas que recontruyen modelos 3d para su correcta impresión, uno de los más sencillos está desarrollado por la plataforma Netfabb.

Utilizando programas de modelado 3D, tanto de licencias abiertas como cerradas. La gran mayoría de los programas de modelado 3d, pueden exportar archivos en este formato. Bien utizando la opción guardar en algunos programas y en otros exportar.

Licencias Libres.
Openscad, Blender, 3dCad...

Licenias Cerradas.
SolidWorks, Rhinoceros, SketchUp, Maya, AutoCad, Revit, 3ds Max... Escaneo 3D. La tegnologia nos permite encanear objetos físicos para generar un modelo digital en 3D. Podemos escanear objetos con cámaras infrarojas, hasta incluso con nuestro telefono móvil con aplicaciones como 123D Catch de Autodesk y descargarlos de forma gratuita.

Modelos online. Empresas y usuarios suben sus modelos 3D a internet para el uso y disfrute la comunidad online. Existen muchas plataformas en las que podemos encontrar multitud de información y modelos stl.

Youmagine, Thingiverse,Github...

1

2

3

STEP 3 STEP 4
Reparar modelos con Netfabb | Importar calypso.ini - Ilaro en Slic3r

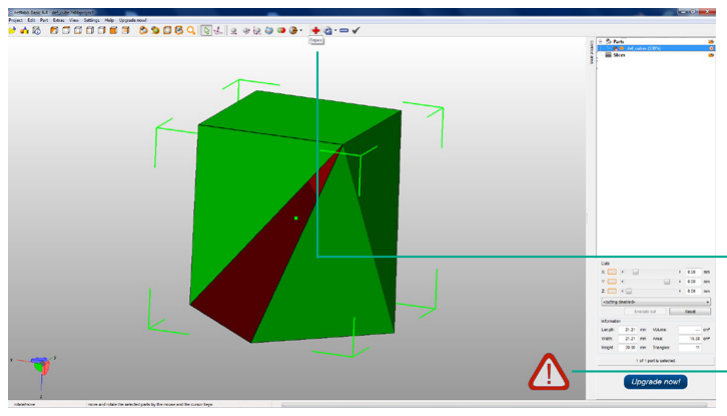
[picture p57: figure]

Arrastramnos el modelo a Netfab. Si el modelo esta mal construido nos aparecera una exclamación y el área problematica en rojo.

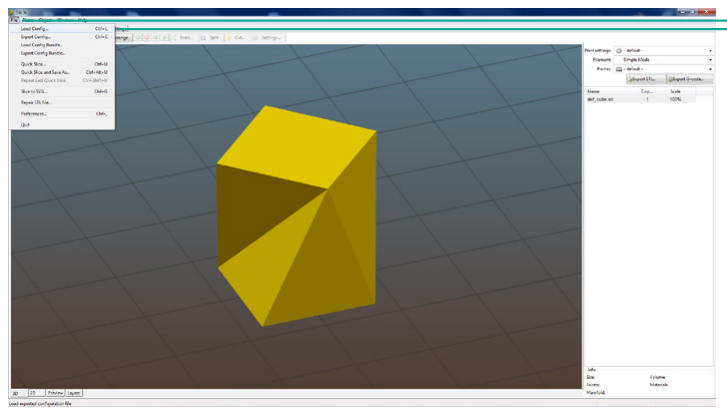
[picture p58: figure]

Hacemos cilk en file.

En este caso, selecionamos el botón reparar (repair).

Seleccionamos Load Conf...

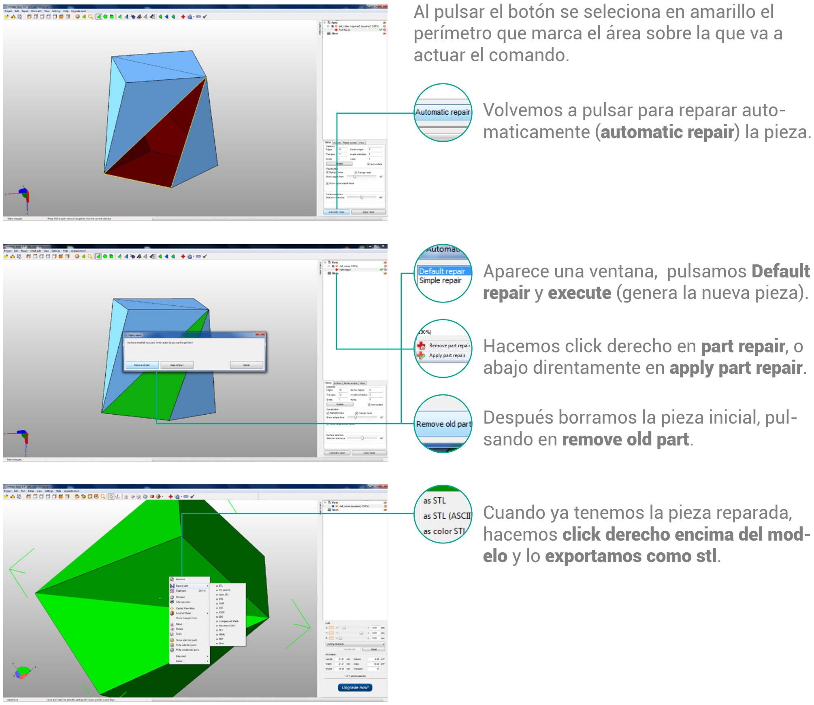
[picture p59: figure]
Volvemos a pulsar para reparar auto- maticamente (automatic repair) la pieza.; Aparece una ventana, pulsamos Default; Hacemos click derecho en part repair, o; Después borramos la pieza inicial, pul- sando en remove old part.; Cuando ya tenemos la pieza reparada, hacemos click derecho encima del mod- elo y lo exportamos como stl.; actuar el comando.

repair y execute (genera la nueva pieza).

abajo direntamente en apply part repair.

Al pulsar el botón se seleciona en amarillo el perímetro que marca el área sobre la que va a

Una vez que tengamos el modelo preparado, para facilitar la configuración de Slic3r, Ilaro ha preparado un archivo de configuración.

El archivo nos proporciona una configuración standar, apta para la impresión de multitud de modelos, lo puedes encontrar en el link: https://github.com/ilaro-org/Calypso/tree/master/firmware%2Bconfigurations

Importar el archivo es muy sencillo.

PLATER

En esta ventana aparece la visualización del área de impresión de la impresora. Aquí es donde arrastraremos o importaremos la el modelo 3d, también tenemos una franja lateral donde podemos cambiar directamente configuraciones previamente guardas.

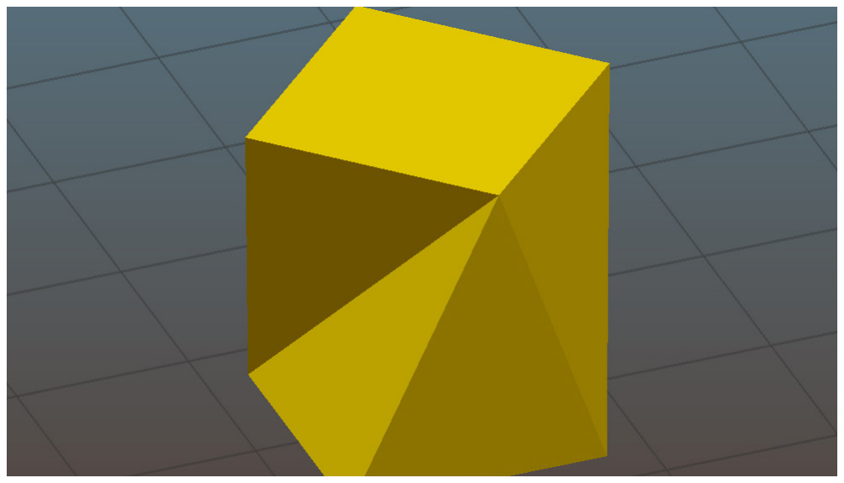
[picture p60: figure]

Las funciones más utilizadas en esta pantalla son:

PRINT SETTINGS

Es el área donde controlamos todos los parámetros que dibujan el modelo cuando lo cortamos; su trayectoria, cantidad de material extruido.... Todos afectan a el proceso de la impresión directamente. La impresión óptima de los modelos se debe al conocimiento y la variación de estos.

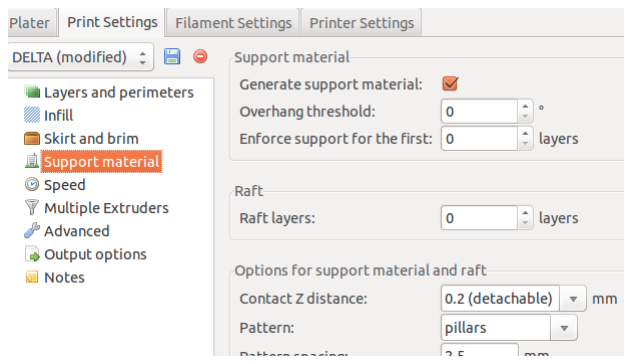
[picture p61: figure]

Los parámetros más útililes a tener en cuenta son:

Rotar
Duplicar modelos
Poner modelos diferentes
Reflejar
Visualizar los las capas cortadas Cambiar configuraciones previas...

Layer height
Perimeters
Spiral vase
Solid Layers Top and Bottom

Fill density
Fill pattern
Fill angle
Infill before perimeters

Generate support material
Contact Z distance
Pattern
Pattern spacing
Pattern angle

Loops
Skirt height
STEP 5

# Slic3r

Slic3r esta organizado en 4 ventanas diferenciadas.

Plater
Print Settings
Filament Settings
Printer settings

Layers and perimetres

Infill

Support material

Skirt and brim

STEP 6

# Posición de la pieza

FILAMENT SETTINGS

Hace referencia a opciones acerca del filamento que vamos a extruir. Según el material y el grosor necesitamos variar funciones en relación a la temperatura y secado.

Es imprescindible conoces las siguientes variable:

PRINTER SETTINGS

Las propiedades que tratan las características físicas de la impresora, el movimiento de estas las podemos variar en estas ventana, también se pueden hacer pequeñas modificaciones en el código ‘gcode’ con el que vamos a imprimir el modelo, destacamos:

Cuidado con todo tipo de agujeros. Ejemplo. En caso de utilizarlos con endiduras para tuercas, y no tener opción a un buen posicionamiento se recomienda poner un soporte, de otra manera quedarán hilos colgando.

Hay que tener en cuenta que la máxima superficie de los objetos que degada a la base de la impresora, esto nos ahorrara problemas de despegado de las piezas durante la impresión. También tenemos que tener en cuenta el grado de inclinación de las diferentes caras de los modelos, en águlos muy cerrados es aconsejable utilizar soportes.

Siempre que el conjunto de la pieza lo permita, los puentes hay que imprimirlos pegados a la base de la impresora. Aún así podemos imprimir puentes pequeños en otras posiciones sin necesidad de soportes.

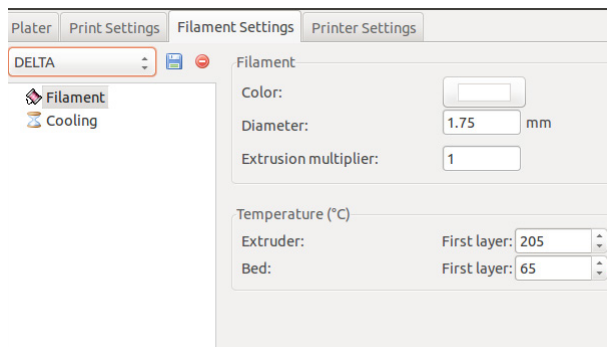
[picture p62: figure]

Diameter
Temperature extruder
Temperature bed

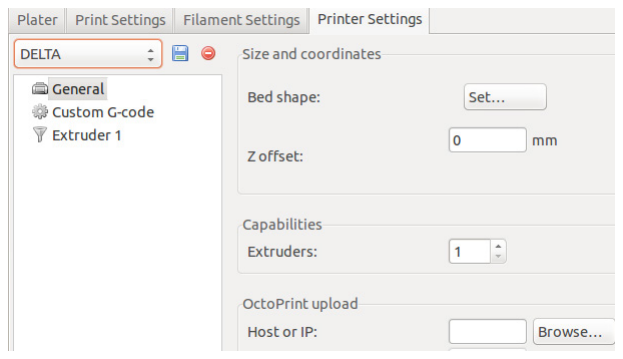
[picture p63: figure]

Bed shape
Firmware

Nozzle diameter
Retraction length
Retraction Wipe while retracting

Keep fan always on
Min print speed

Filament

General

Cooling

Extruder

Cuando imprimimos en 3d un modelo es muy importante su posicionamiento a la hora. Tenemos que tener en cuenta la pieza en su conjunto, tanto como la inclinación de sus ángulos, perforaciones, puentes, base, soportes... Si tenemos en cuenta estos factores, obtendremos buenos acabados nuestras impresiones.

La pieza no siempre es fácil posicinarla en un programa de corte como Slic3r, aconsejamos importar los modelos bien posicionados con anterioridad.

Errores comúnes de posicionamiento:

2016 | ilaro.org

LICENCIA GPL.V3.

MANUAL REALIZADO POR
Miguel Barrio González
