ilaro-org/Calypso/manuals/ManualExtrusor.pdf

LICENCIA GPL.V3.

### VERSION 1

H2

## EXTRUSSION PROBLEMS

## ILARO.ORG

Release the extruder screw (if it is calibrated you can count 10 full turns so later you can tight it 10 full turn an get back the pre-calibrated pressure)

Heta the hotend and once it reaches 220 fastly pull up the filament out of the hotend-bowden-extruder.

Cut and trash the previously extruded filament to get fresh new unmarked filament.

Examine the filament. how is the bitting the drive wheel has left marked? In case of doubt proceed to step 2.

1

2

4

3

1 STEP

# Initial Diagnosis

Opcion a. Does it have a circular bite? then follow to step 2.

Opcion b. Not visible? then you may just skip to step 4.

# Nozzle Impurities

Hot end clogged?
Impurities in the filament or rarely dust being dragged into the nozzle.

Place a wood part in between the nozzle and the bed so you can release the bowden tube.

Do so by making pressure over the endeffector with one hand and pulling the tube with the other. Important! push the red part on the pushfit prior to pulling the tube.

1

2

Heat the nozzle to 220ºC and directly extrude plastic by hand. Do this until succesful manual extrude. this sometiems can take quite a lot of time. Stress is your enemy.

Cut the deformed filament to always push in fresh perfectly round filament.

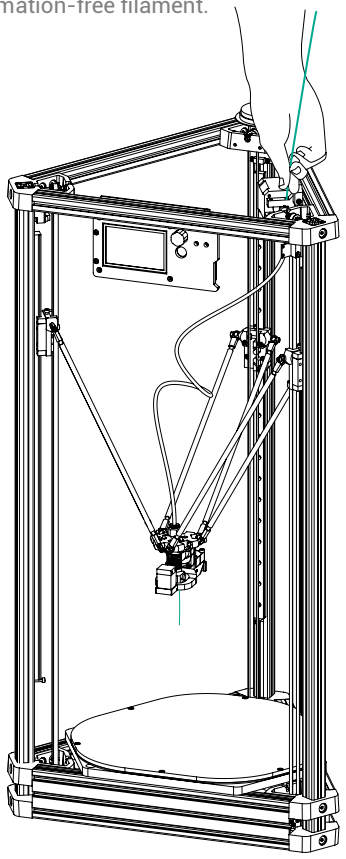
[picture p64: figure]

Opcion b.
If plastic comes up nicely (not curling at the exit of the nozzle and without ) skip to next step.

Opcion a.
Flush the debris. alternate with the high-pressure pushing very fast full-length retractions, we do this is order to drag out debris stacked in the nozzle too big to fit through.

3

3

# Friction Deformed Filament

Is bowded ok?
Most of the times the real problem is a deformed
filament creating excesive friction inside the tube.

Cut fialment to get fresh texture-free, deformation-free filament.

If you get stacked at this point contact us.

Push the bowden tube back in the
pushfit and extrude manually from the
top side of the filament. Important! dont forget to heat the hotend to 220ºC and to release the extruder screw force necessary should be the same as the force employed at the end of step2.

1

3

2

# Pressure

Is the pressure over the filament-drive wheel optimal?

## FIXED

It can be underpressured. In such case the teeth in the drive wheel dont create enough grip to force the filament down with enough force.

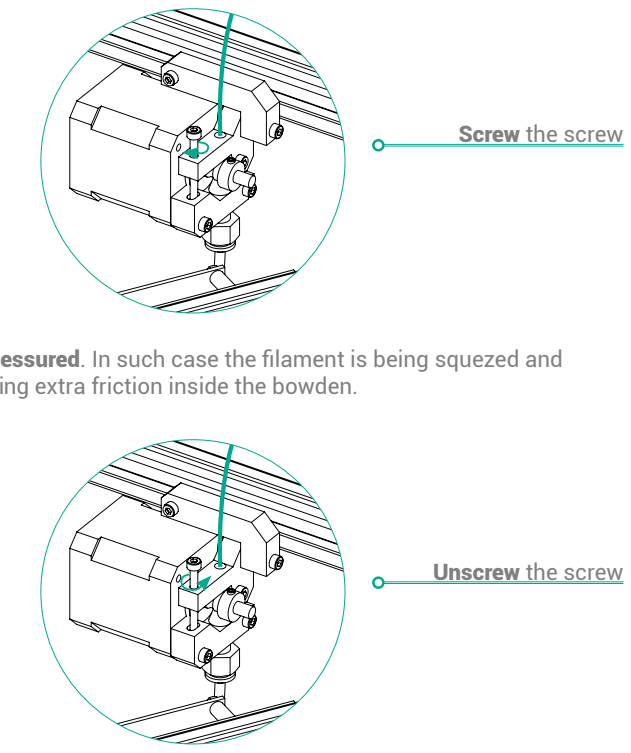
[picture p65: figure]
Unscrew the screw; Screw the screw

It can be overpressured. In such case the filament is being squezed and deformed creating extra friction inside the bowden.

If none of this works back to the first step.

1

2

3

DISEÑO GRÁFICO
Miguel Barrio González
Irene Ródenas Sáinz de Baranda Raúl Nieves Pardo

DISEÑO INDUSTRIAL
Enric Brasó Vives
Raúl Nieves Pardo
