ilaro-org/Calypso/manuals/ManualCalibracion.pdf

H2

## CALIBRATION

LICENCIA GPL.V3.

### VERSION 1

## ILARO.ORG

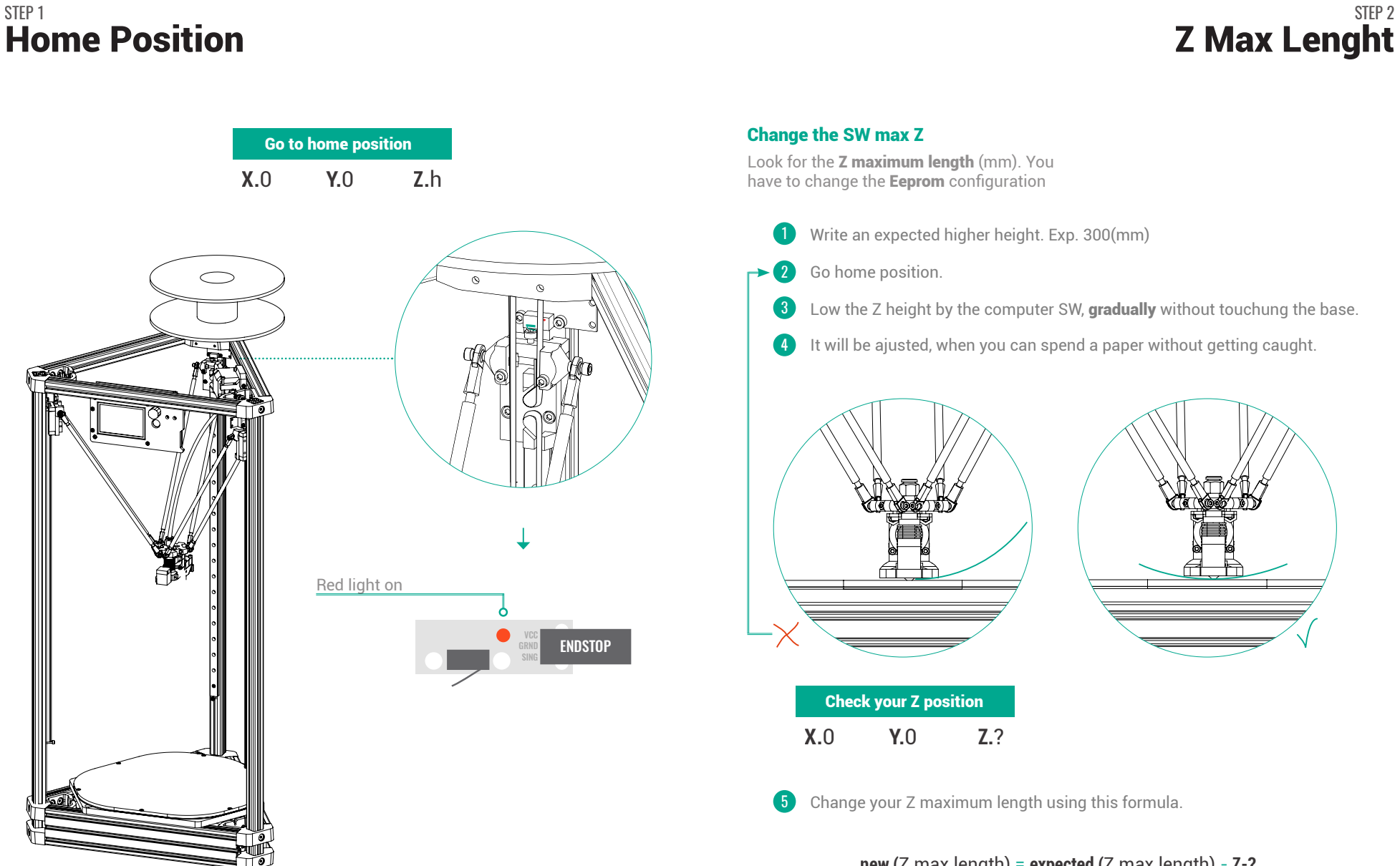
[picture p66: figure]
STEP 1 STEP 2; Home Position; Z Max Lenght; Go to home position; Change the SW max Z; Go home position.; VCC GRND; SING; ENDSTOP; Red light on; Look for the Z maximum length (mm). You have to change the Eeprom configuration; Check your Z position

Write an expected higher height. Exp. 300(mm)

It will be ajusted, when you can spend a paper without getting caught.

Low the Z height by the computer SW, gradually without touchung the base.

Change your Z maximum length using this formula.

new (Z max.length) = expected (Z max.length) - Z-?

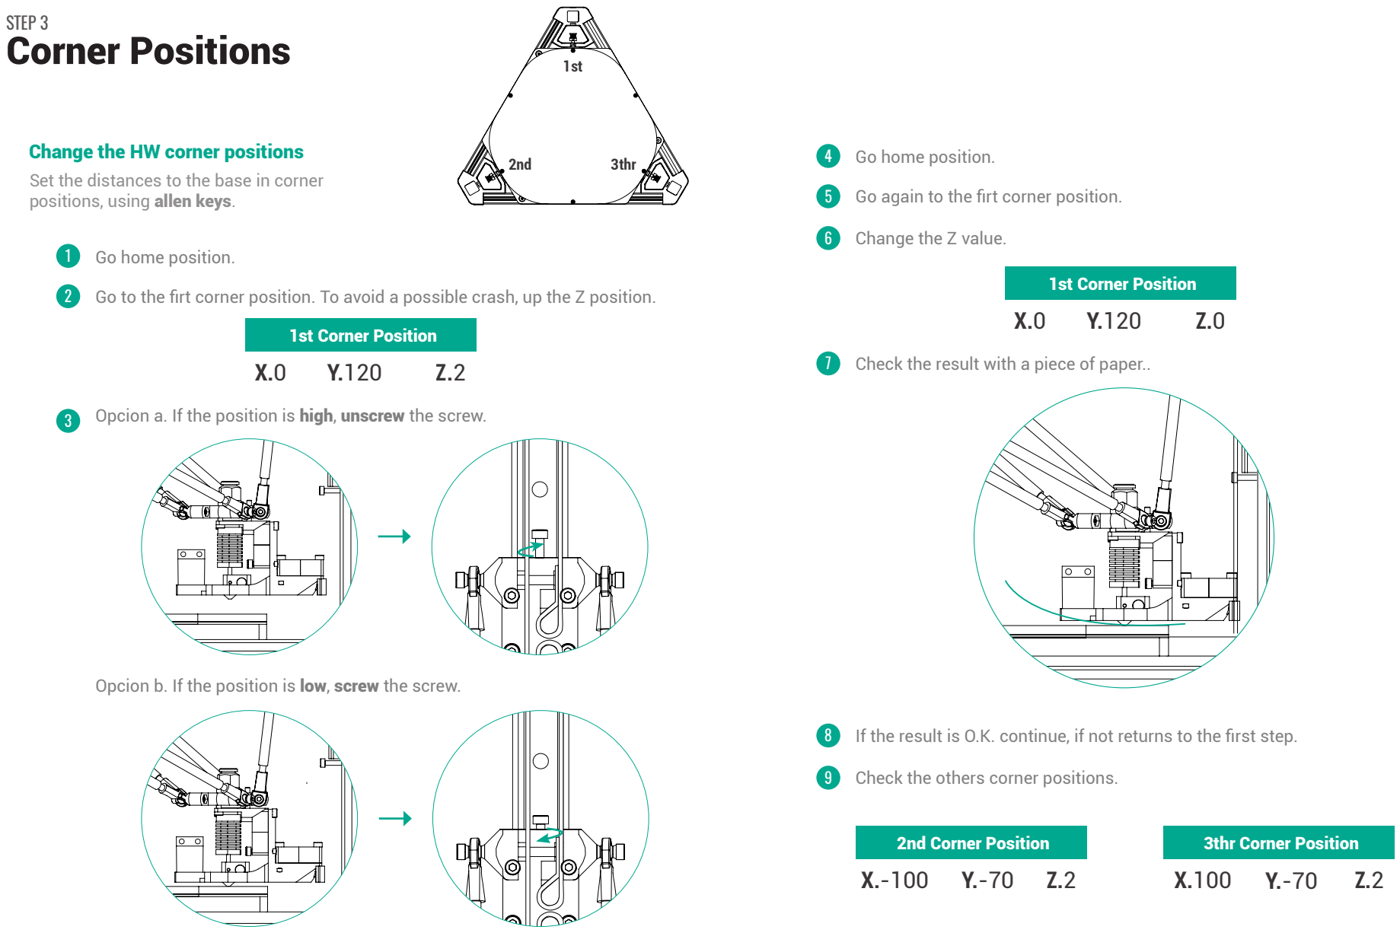
[picture p67: figure]
STEP 3 Corner Positions; Change the HW corner positions; Go home position.; Go again to the firt corner position.; Change the Z value.; Check the others corner positions.; Set the distances to the base in corner positions, using allen keys.; 1st Corner Position; 2nd Corner Position; 3thr Corner Position; 3thr

Go to the firt corner position. To avoid a possible crash, up the Z position.

Check the result with a piece of paper..

If the result is O.K. continue, if not returns to the first step.

Opcion a. If the position is high, unscrew the screw.

Opcion b. If the position is low, screw the screw.

STEP 4 STEP 5
Diagonal Straight Path | Model Real Dimensions
Change the SF horizontal radius | Change the SF diagonal rod length

Go home position.
Go to the firt corner position, move to the opposite position and look at the movement of his career. To avoid a possible crash, up the Z position.

Adjust the value according to the movement.

Check your change, if not O.K. repeat the instucion.

Set the Eeprom configuration, changing the horizontal radius (mm) value.

Set the Eeprom configuration, changing the diagonal rod length (mm) value.

1

2

3

3

1st Corner Position | Oposite Corner
X.0 | Y.120 | Z.2 | X.0 | Y.-120 | Z.2

Opcion a. happy

Increases the horisontal
radius to be happy

Decreases the horizontal
radius to be not too happy

Opcion b. sad

Print a simple model like a rectangle.

Measure your printed model in the largest dimension.

Compare the measurements of your printed model with your computer model. If is incorrect, change the diagonal rod length value, using this formula.

X printed model (mm)

1

2

3

new diagonal rod length =

diagonal rod length * printed (model) computer (model)

## CALIBRATED

DISEÑO GRÁFICO
Miguel Barrio González
Irene Ródenas Sáinz de Baranda Raúl Nieves Pardo

DISEÑO INDUSTRIAL
Enric Brasó Vives
Raúl Nieves Pardo
