ilaro-org/Calypso/manuals/Manual.pdf

H2

ILARO.ORG

LICENCIA GPL.V3.

VERSION 1

## Screws

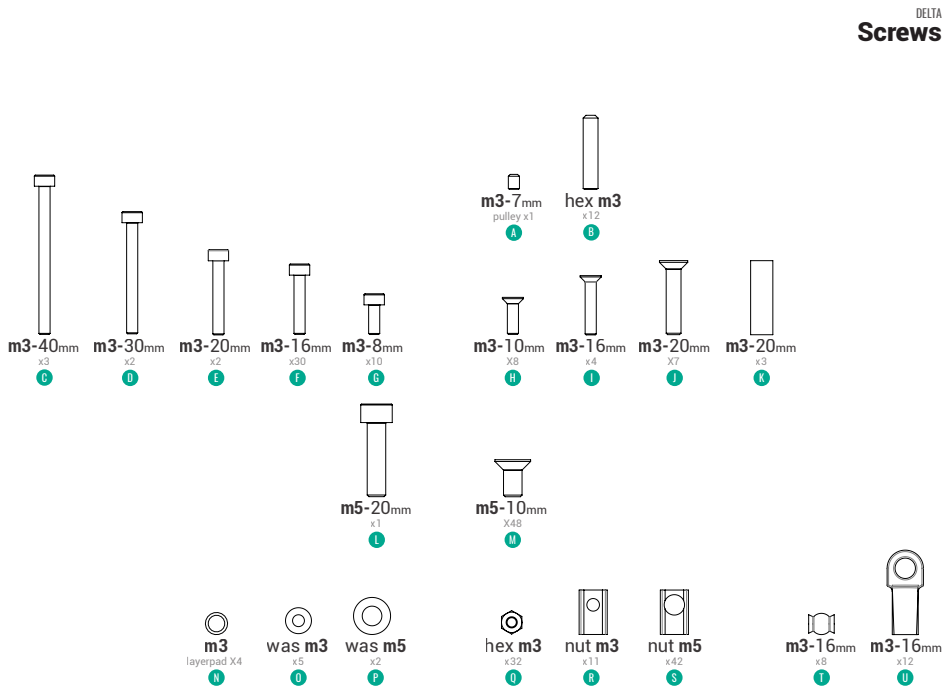
[picture p68: page 2]
nut m3 nut m5; pulley x1 A; layerpad X4; hex m3; was m3; was m5; DELTA

Profiles | Power plate

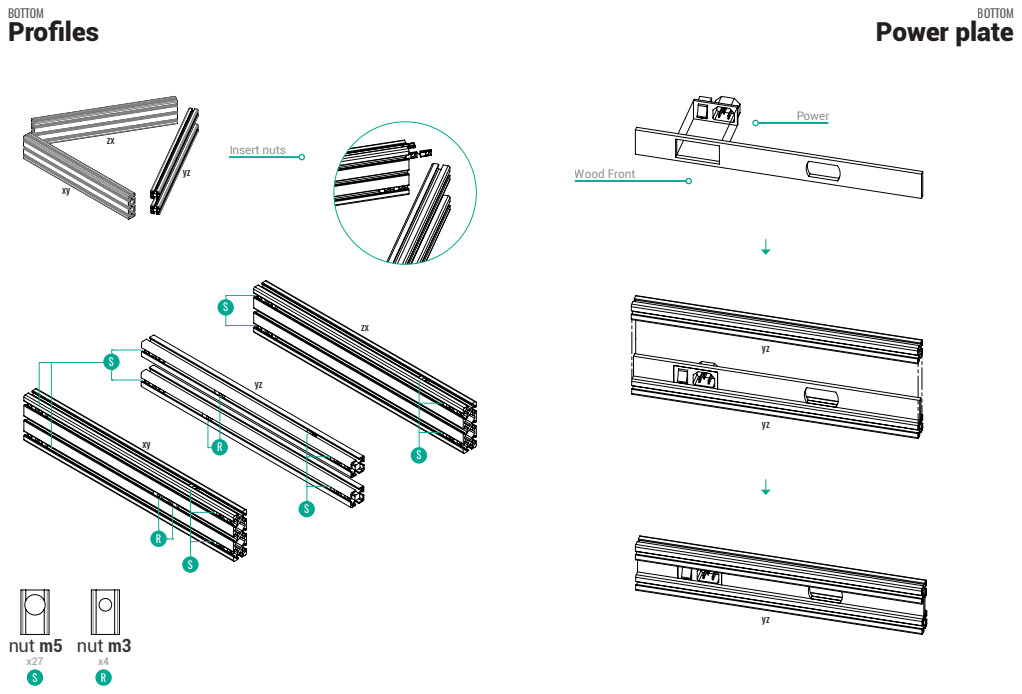
[picture p69: page 3]
BOTTOM; nut m5 nut m3; Insert nuts; Power; Wood Front

## Frames

## Frames

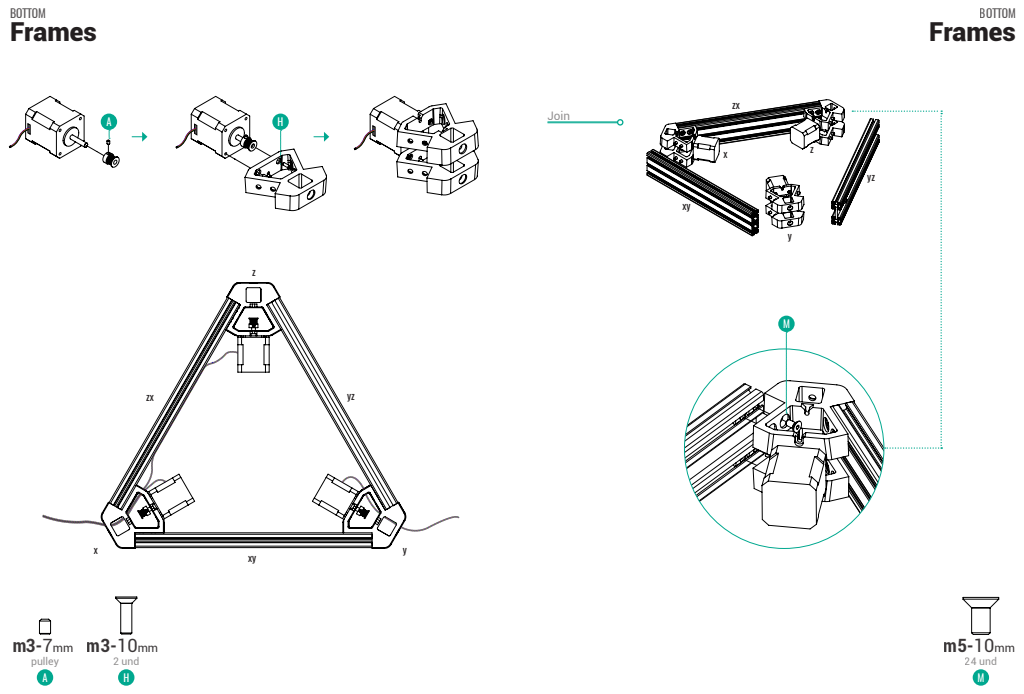
[picture p70: page 4]
BOTTOM; pulley; 2 und; 24 und; Join

Bed | Bed

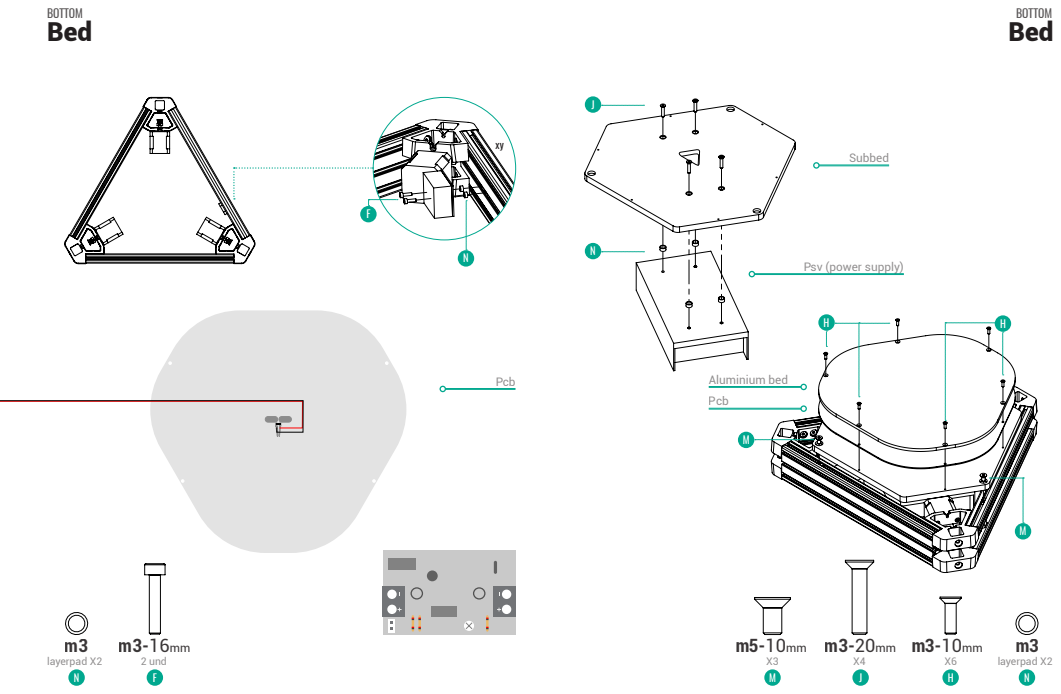
[picture p71: page 5]
BOTTOM; layerpad X2 M; 2 und; layerpad X2; Pcb; Aluminium bed; Subbed

Psv (power supply)

## Profiles

## Endstop

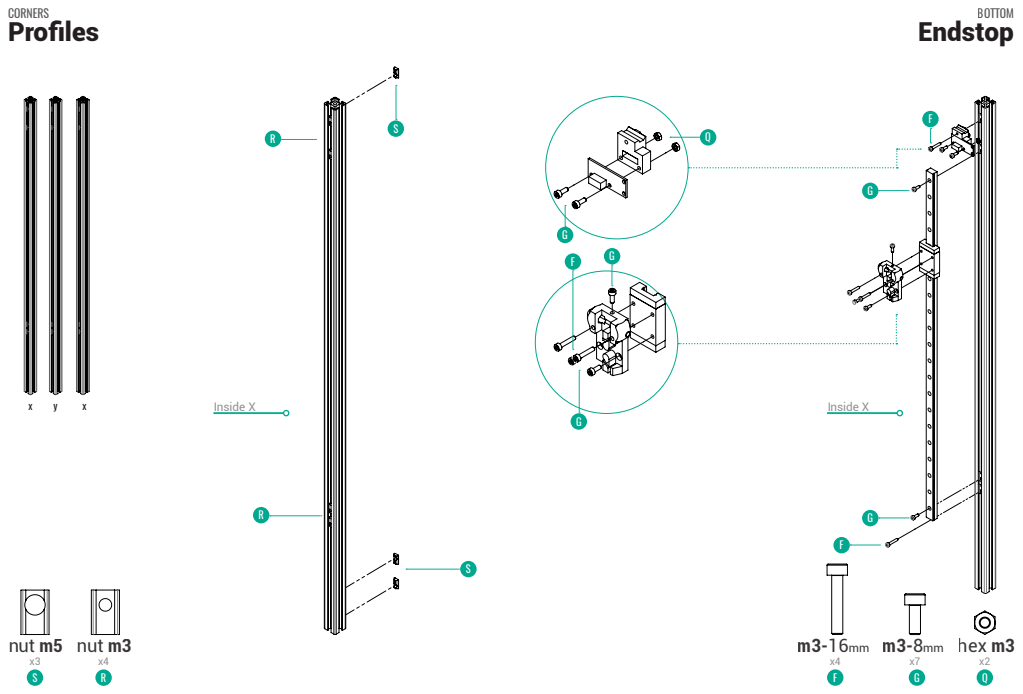
[picture p72: page 6]
CORNERS; BOTTOM; nut m5 nut m3; hex m3; Inside X

## Profiles

## Frames

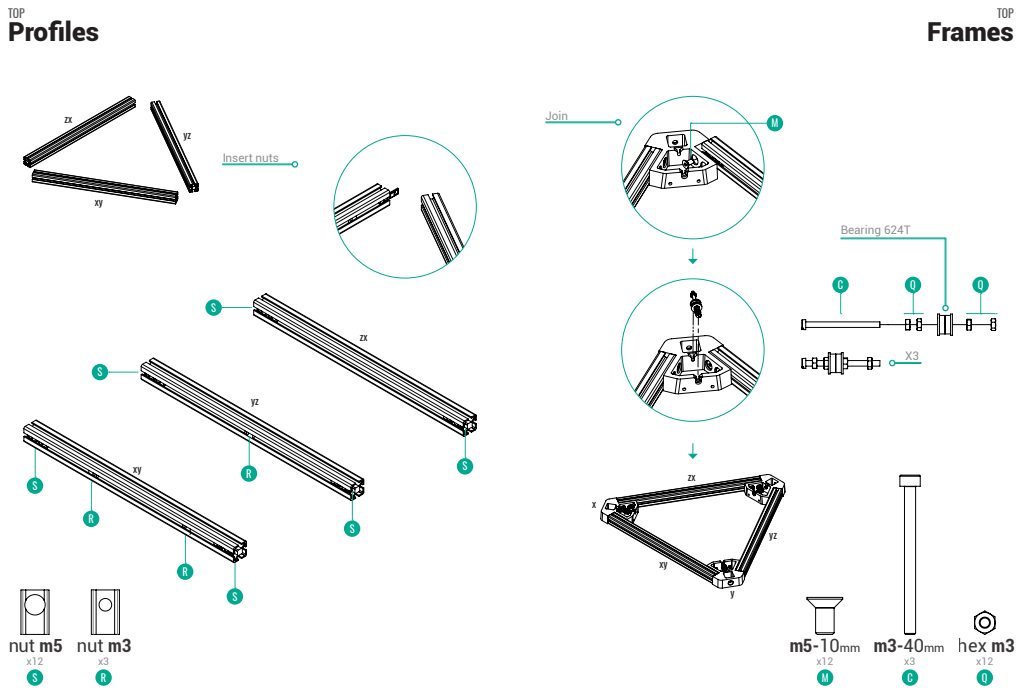
[picture p73: page 7]
TOP; nut m5 nut m3; Insert nuts; hex m3; Join; Bearing 624T

## Join Parts

## Join Parts

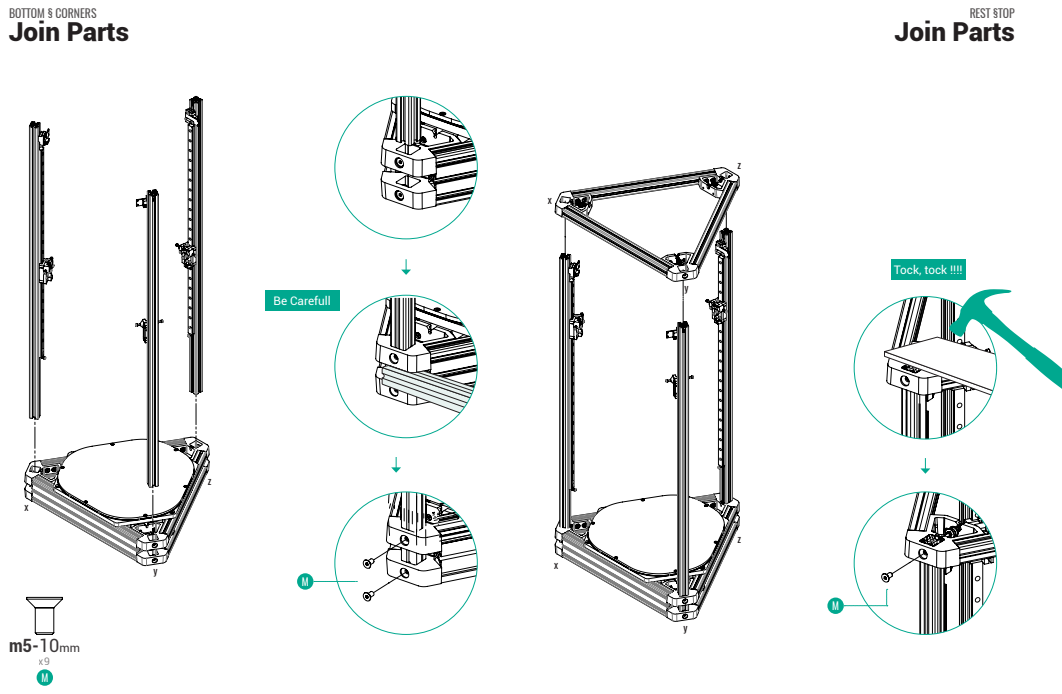
[picture p74: page 8]
BOTTOM § CORNERS; REST §TOP; Tock, tock !!!!; Be Carefull

## Belts

## Effector

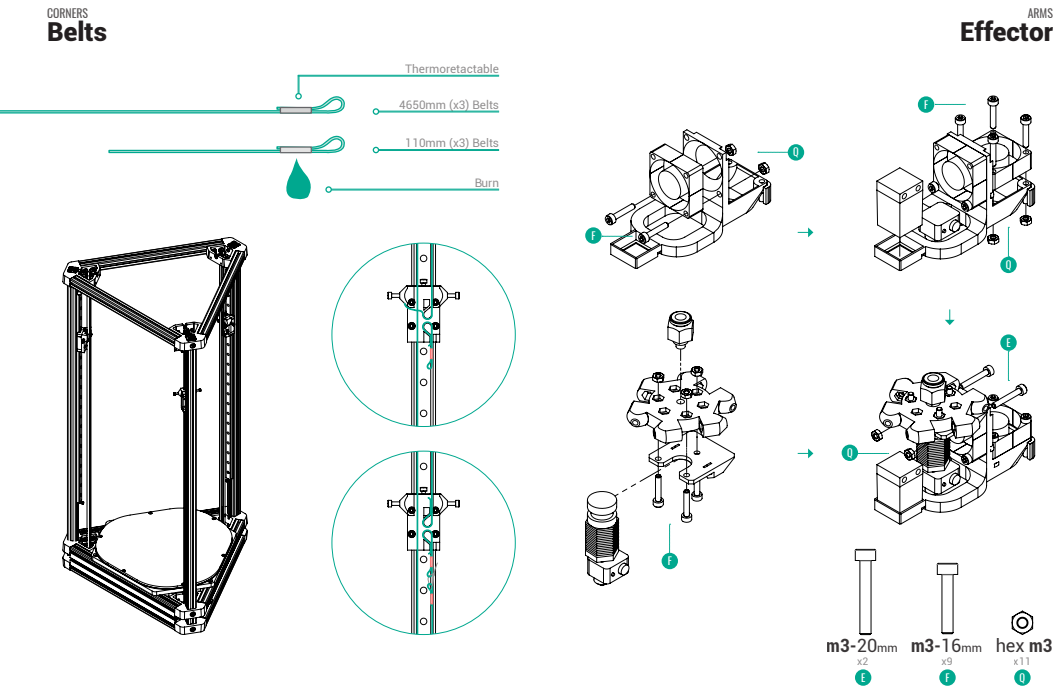
[picture p75: page 9]
CORNERS; 110mm (x3) Belts; Burn; 4650mm (x3) Belts; Thermoretactable; hex m3; ARMS

## Arms

## Join Parts

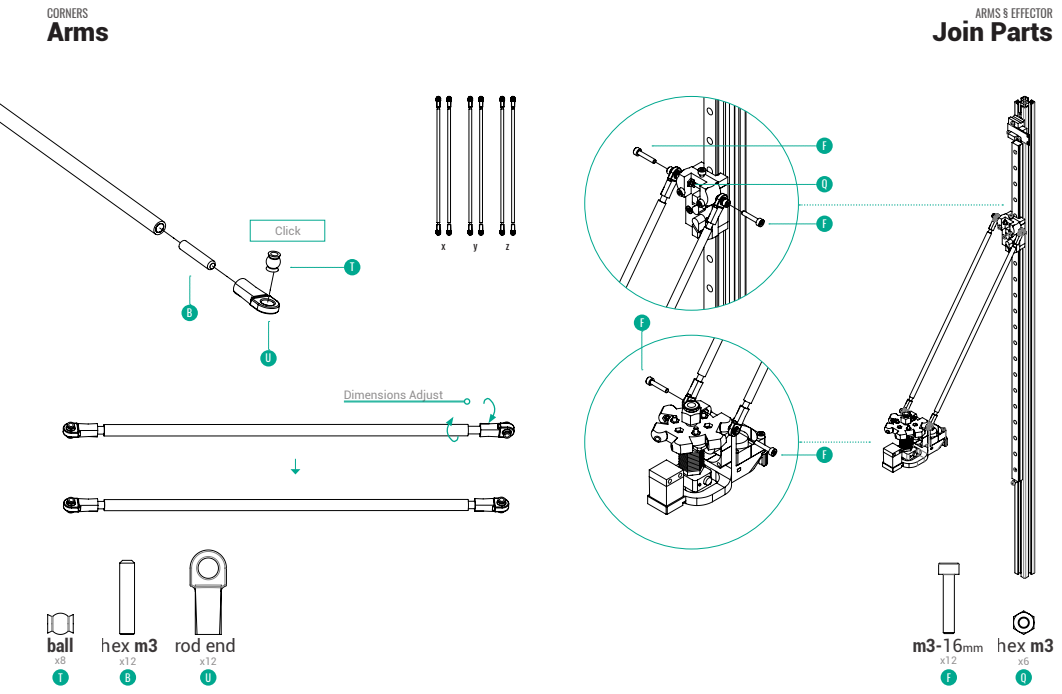
[picture p76: page 10]
CORNERS; ARMS § EFFECTOR; hex m3 rod end; hex m3; ball; Click; Dimensions Adjust

## Extruder

## Join Extruder

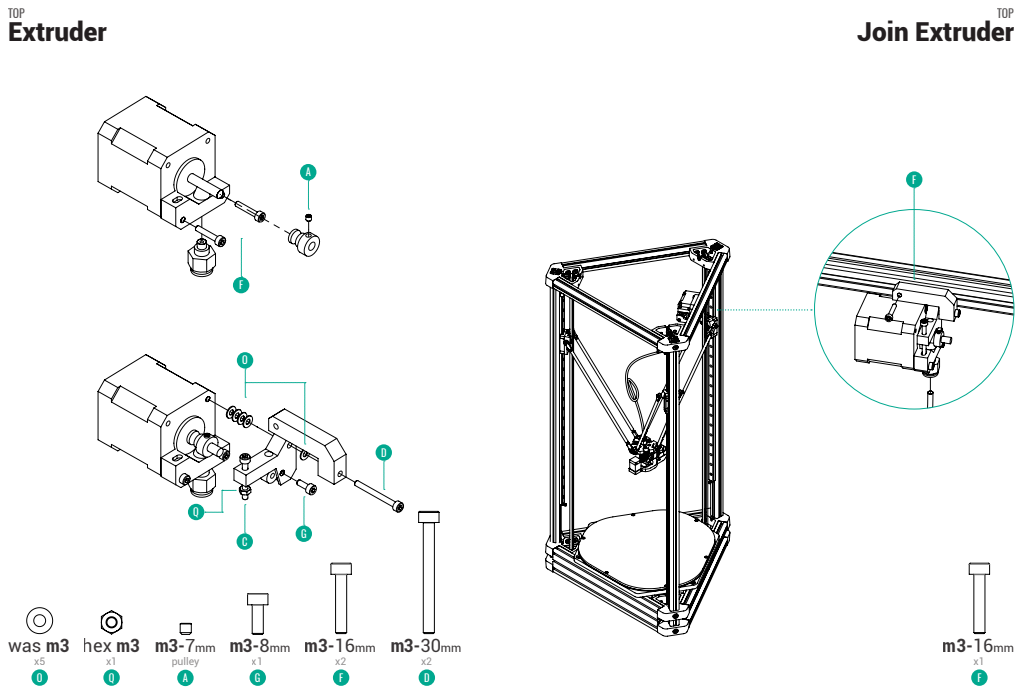
[picture p77: page 11]
TOP; was m3 hex m3; pulley A

## Join

## Front Plate

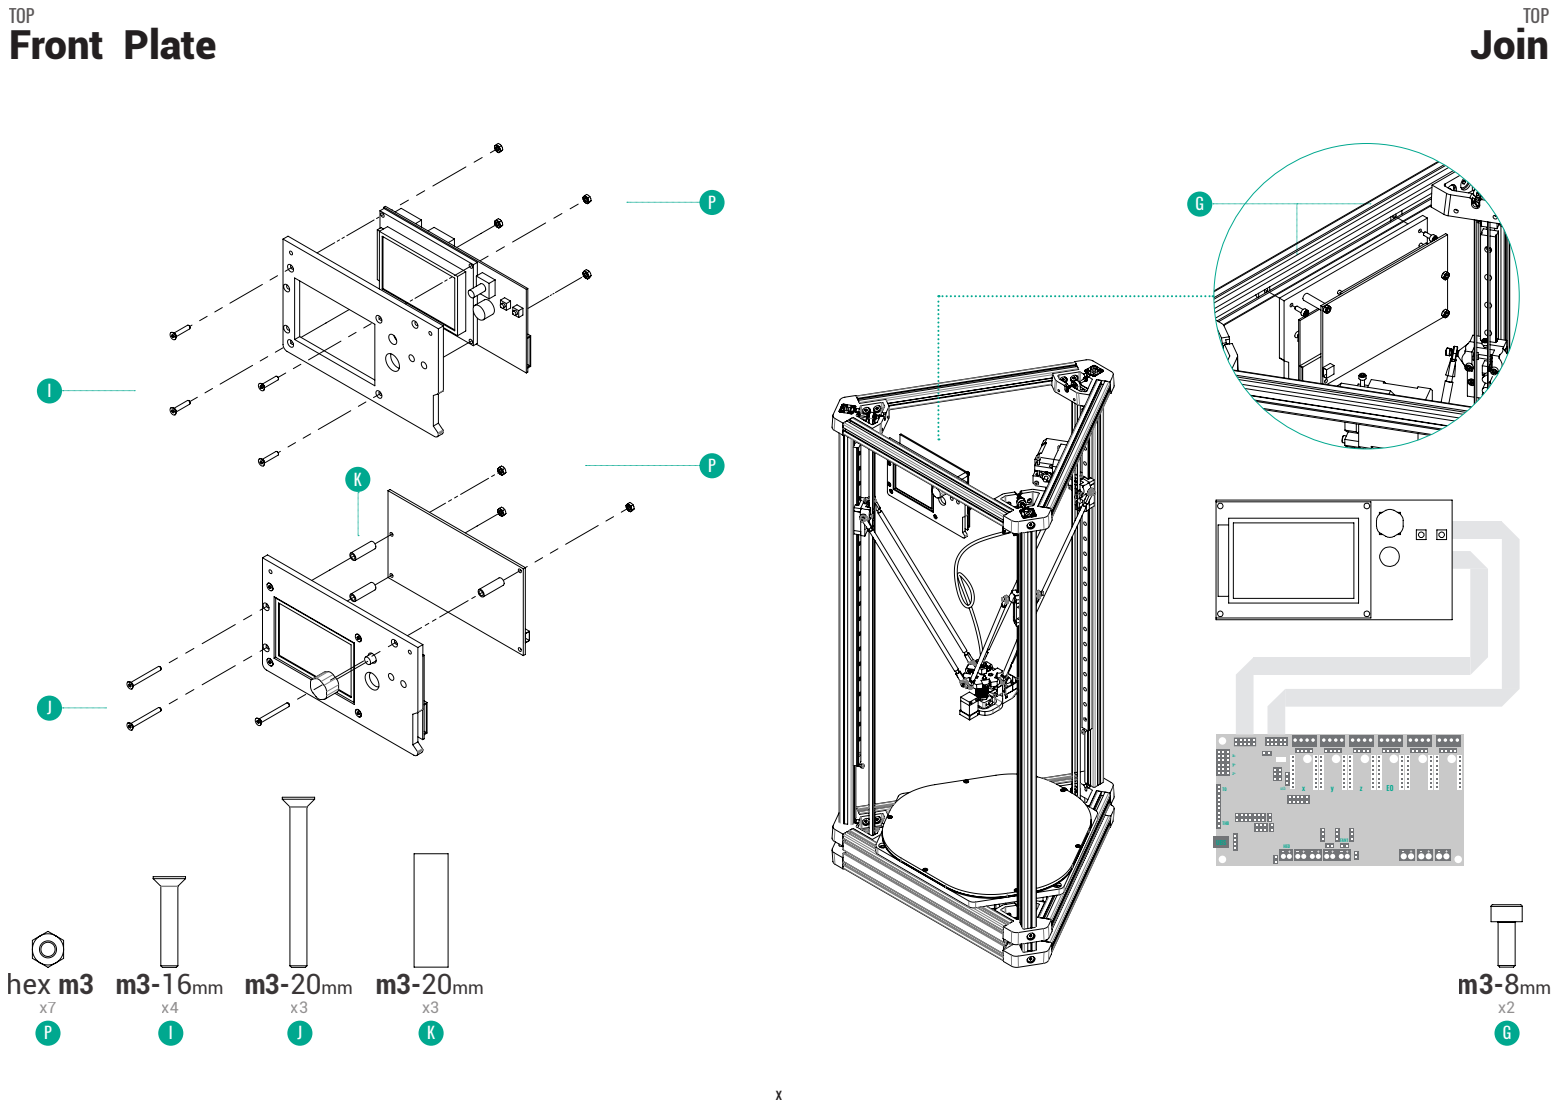
[picture p78: page 12]
TOP; hex m3; THB; usb; FAN1; HE0 UBS

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

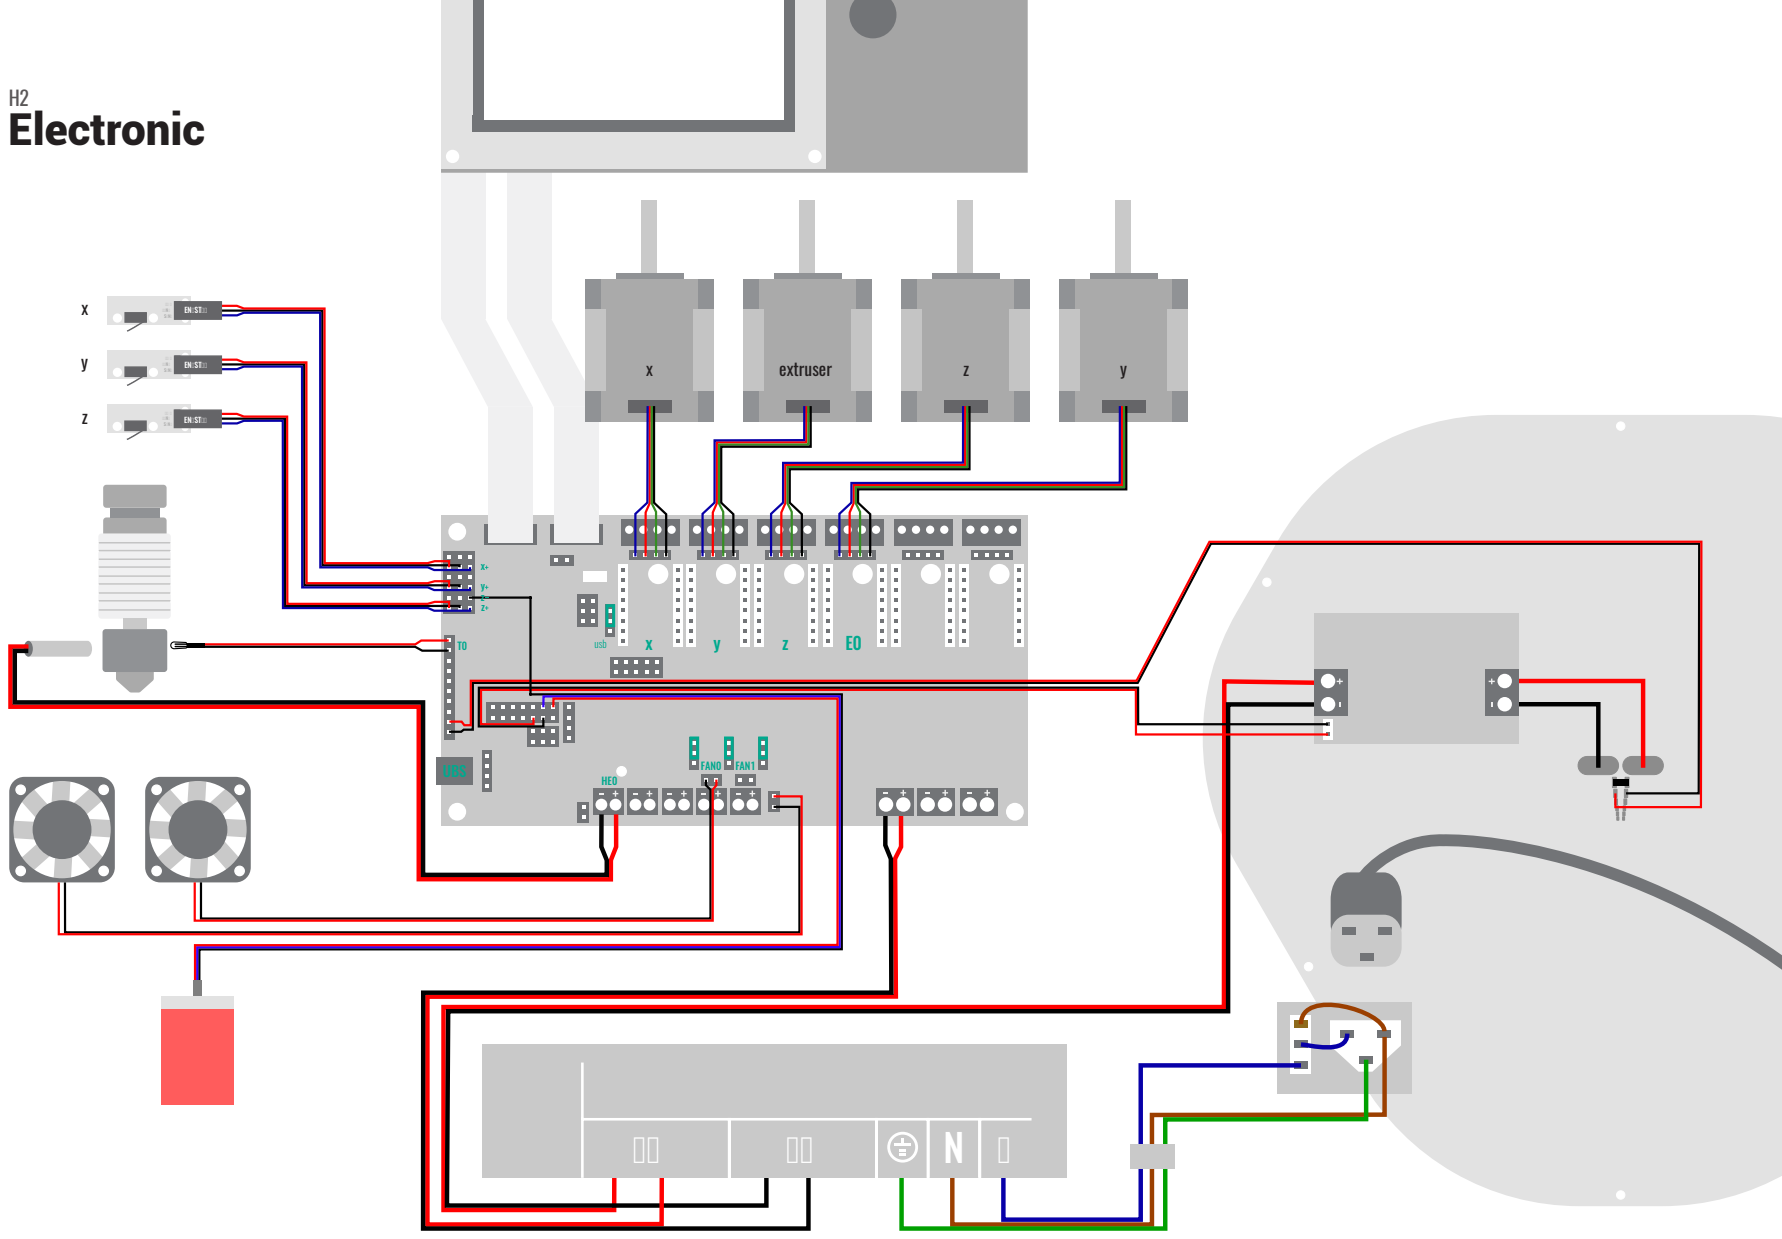
[picture p79: page 13]

## Spoolholder

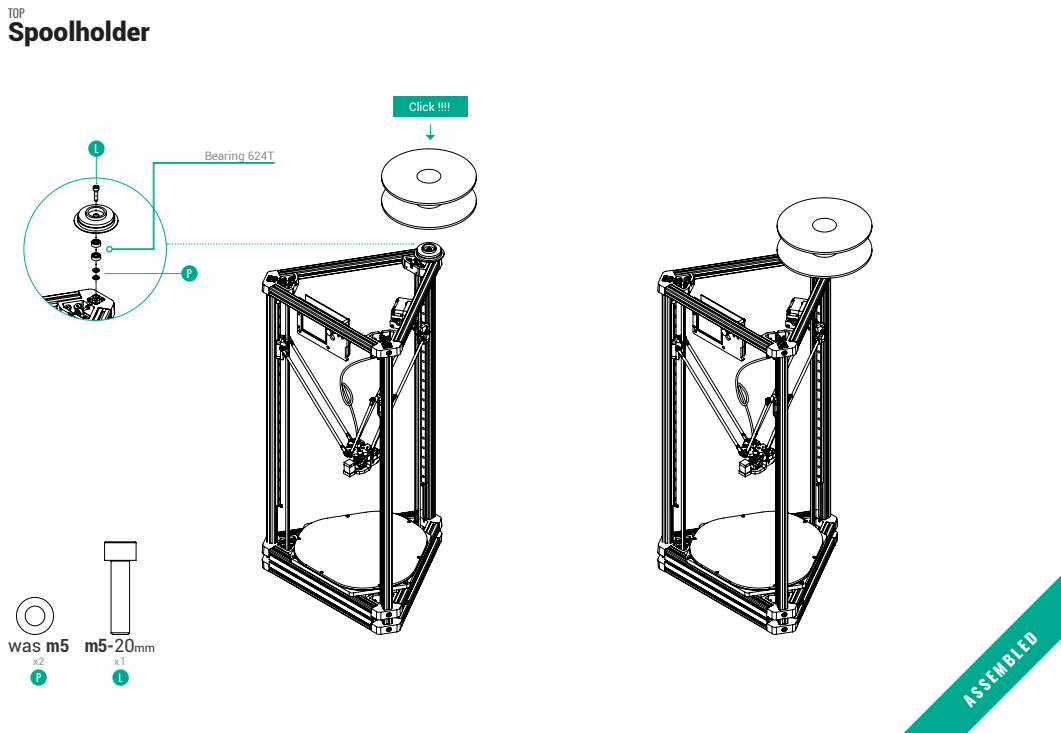
[picture p80: page 14]
TOP; was m5; Bearing 624T; Click !!!!; ASSEMBLED

DISEÑO GRÁFICO
Miguel Barrio González
Irene Ródenas Sáinz de Baranda Raúl Nieves Pardo

DISEÑO INDUSTRIAL
Enric Brasó Vives
Raúl Nieves Pardo
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
