ilaro-org/Calypso/(commit log)

2015-12-09 updated paths
    [Pull filament_V2.STL, Push filament_V2.STL, alu bed^bed_V2.DXF, carriage_V2.STL, endeffector_V2.STL, endstop holder_V2.STL, extruder holder_V2.STL, front plate holder_2.DXF]
2016-06-07 old radio files removed
    [Pull filament_V2.STL, Push filament_V2.STL, alu bed^bed_V2.DXF, carriage_V2.STL, endeffector_V2.STL, endstop holder_V2.STL, extruder holder_V2.STL, front plate holder_2.DXF]
